mrWheel/DSMRloggerWS/mkdocs/docs/hardware_V4_Programmer.md

## Programmer voor de DSMR-logger V4

Er zijn verschillende manieren om de DSMR-logger van (nieuwe) firmware
te voorzien. Dit gaat het eenvoudigst *Over The Air* (OTA) maar de
eerste keer zal dit altijd bedraad moeten.

* [FTDI-adapter](#ftdi-adapter)
* [USB to Serial adaptor bordje](#usb-to-serial-adaptor-bordje)
* [USB to TTL adaptor kabel](#usb-to-ttl-serial-adaptor-kabel)
* [Flashen (programmeren)](#flashen-programmeren)

<hr>
### FTDI-adapter
Verreweg de betrouwbaarste oplossing is om gebruik te maken van een FTDI adaptor
zoals de 
<a href="https://opencircuit.nl/Product/15140/SparkFun-FTDI-Basic-Breakout-5V" target="_blank">
FTDI-basic</a>
van Adafruit.   
Hou er rekening mee dat de USB-connector op de FTDI-basic geen *micro*-USB is maar
de iets grotere *mini*-USB variant!

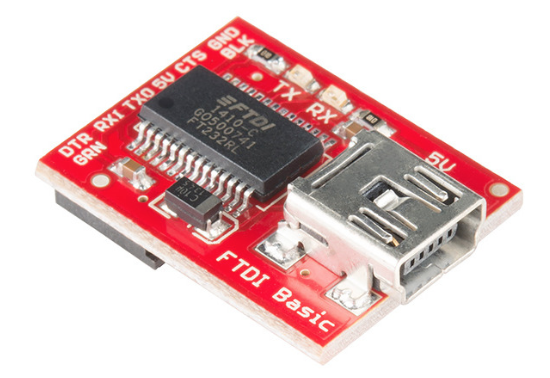
[picture p9: mkdocs/docs/img/Sparkfun_FTDI-basic_5v.png]


Standaard wordt deze als 5Volt adaptor geleverd, maar aan de achterkant kun je,
door het spoor tussen de middelste pad en de 5V pad te onderbreken en een soldeer 
brug aan te brengen tussen de middelste pad en de 3.3V pad, de adaptor
geschikt maken voor 3v3.

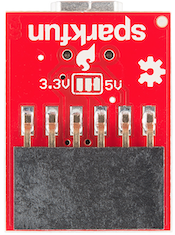
[picture p10: mkdocs/docs/img/Sparkfun_FTDI_Back.png]


Je moet de volgende verbindingen maken:

| FTDI-basic | DSMR-logger | Opmerking |
|:---:|:---:|:---|
| 5V  | 3v3 | LET OP! **3v3** |
| GND | GND ||
| TXO | RxD ||
| RXI | TxD ||

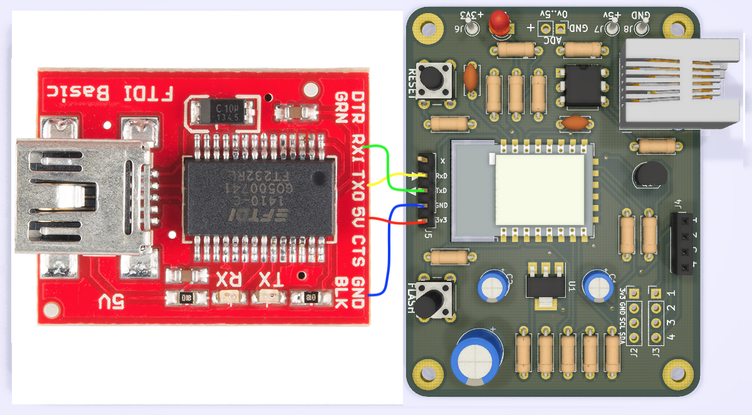
[picture p11: mkdocs/docs/img/DSMR-logger_V4-FTDI.png]


<hr>
### USB to Serial adaptor bordje
Ook een 
<a href="https://opencircuit.nl/Product/11544/ESP-01-USB-Adapter" target="_blank">
USB-to-Serial adapter</a>
is eenvoudig als programmer te gebruiken
door met vier draadjes verbinding tussen de USB-to-Serial Adapter en 
de *DSMR-logger v4* te maken volgens onderstaand schema:

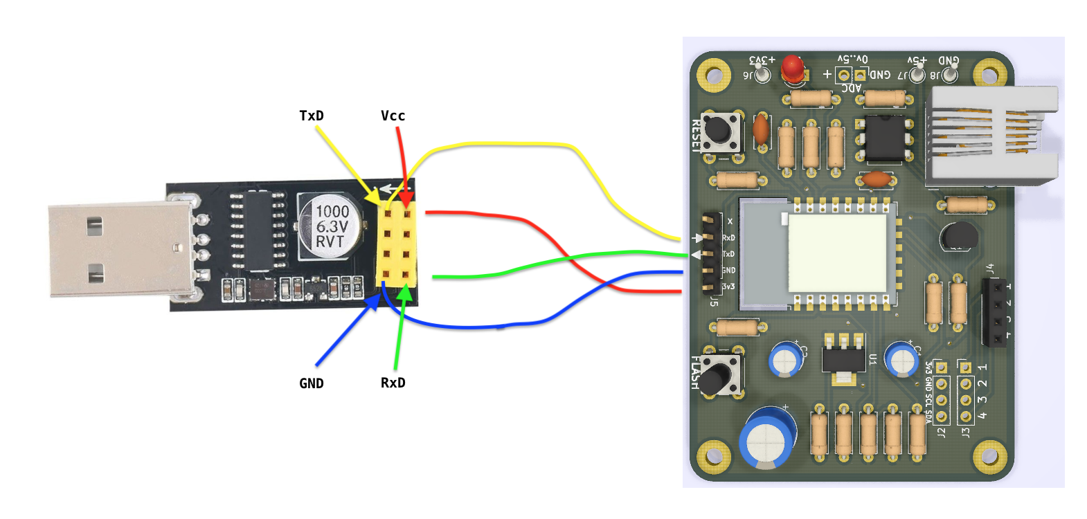
[picture p12: mkdocs/docs/img/USB2Serial_DSMRlogger_v4.png]


<del>Let op! Het heeft er alle schijn van dat dit bordje niet meer '*gezien*' wordt
onder **MacOS 10.14**!</del>

<hr>
### USB to TTL Serial adaptor kabel
Ook 
<a href="https://opencircuit.nl/Product/12809/USB-to-TTL-Serial-Cable-Debug-Console-Cable-for-Raspberry-Pi" target="_blank">
deze</a>
USB-to-Serial kabel is eenvoudig als programmer te gebruiken alleen moet je er 
rekening mee houden dat de geleverde spanning <b>5 volt</b> is en je deze dus
niet op de programming poort van de DSMR-logger V4 mag aansluiten.   
Sluit de USB-to-Serial kabel op deze manier aan om zonder problemen de
DSMR-logger V4 te kunnen programmeren.

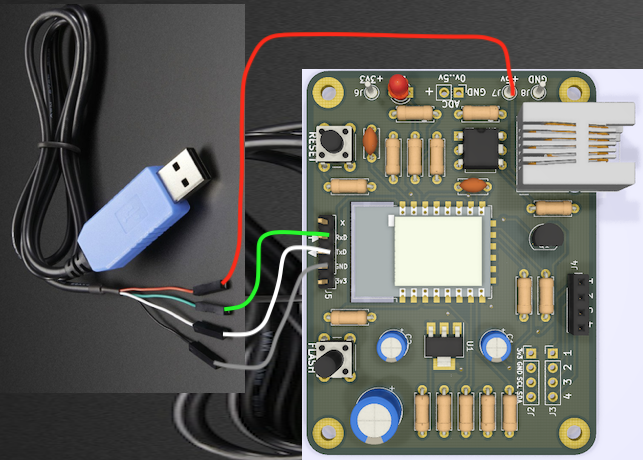
[picture p13: mkdocs/docs/img/USB2TTL_5Volt_DSMR-logger.png]


<hr>
### Flashen (programmeren)
Omdat de DSMR-logger V4 geen aansluitingen voor specifieke controle signalen heeft
moet je in de ArduinoIDE aangeven dat je bij het uploaden
van firmware of de `data`-map geen speciaal protocol gebruikt.
In het `Tools`-menu geef je bij `Reset Method` ***None*** op.

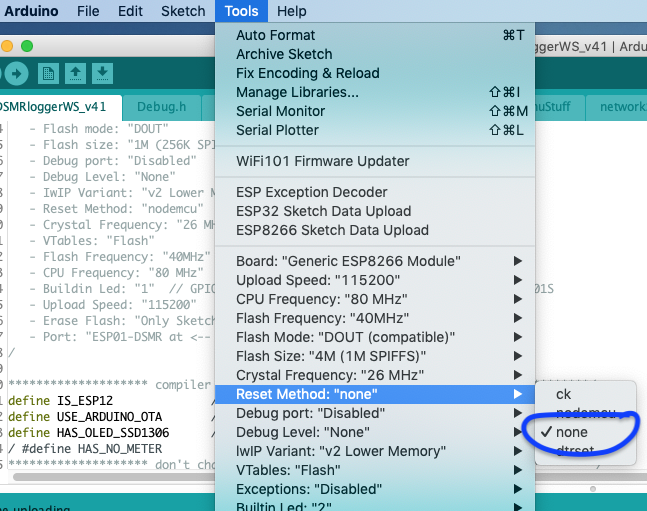
[picture p14: mkdocs/docs/img/ToolsResetMode.png]


Om nu de firmware of de `data`-map naar de *DSMR-logger v4* te flashen
moet je de *DSMR-logger v4* ***eerst*** in `Flash-mode` zetten.

<div class="admonition note">
<p class="admonition-title">Let op!</p>
Koppel, vóórdat je de programmer op de <i>DSMR-logger v4</i> aansluit, éérst
de <i>Slimme Meter</i> los!
</div>

Dit doe je door achtereenvolgens deze handelingen uit te voeren:

1. Druk op de `FLASH` knop en houdt deze ingedrukt
2. Druk vervolgens op de `RESET` knop
3. Laat de `RESET` knop los
4. Laat als laatste de `FLASH` knop los

De DSMR-logger staat nu in `Flash-mode`  en blijft in die mode tot er firmware
of de inhoud van de `data`-map wordt ge-upload (of tot je nog een keer op de
`RESET` knop drukt).

Hierna hoort de DSMR-logger normaal op te starten. Mocht dit niet het geval zijn
druk dan 1x op de `RESET` knop..

Zie ook [`Vraag en Antwoord`](QenA.md#5-volt-programmer)

<br>

---
<center style="font-size: 70%;">[ChartActueel]</center>
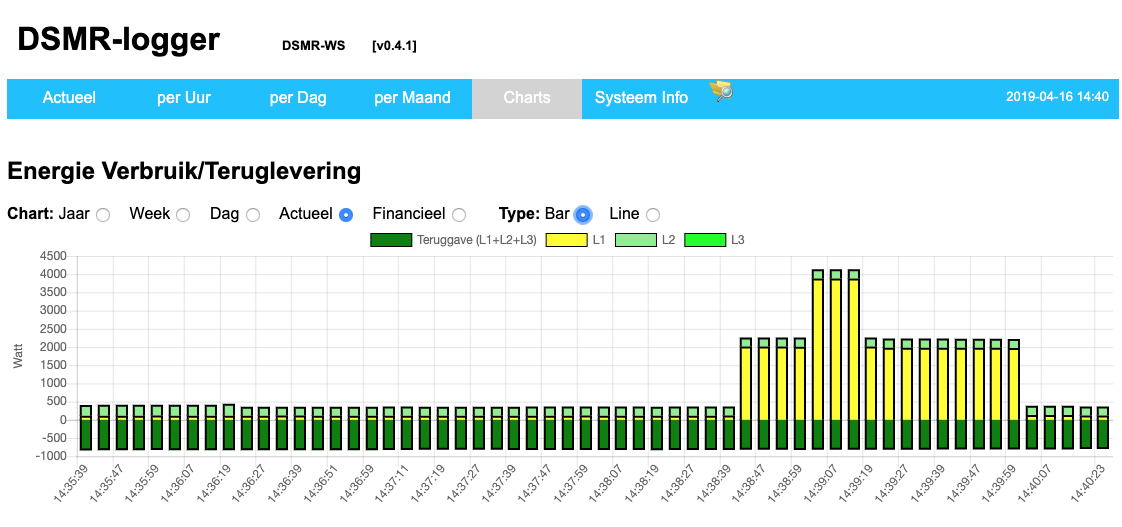
[picture p15: mkdocs/docs/img/ChartActueel.png]
