mrWheel/DSMRloggerWS/mkdocs/docs/benodigdeBibliotheken.md

## Benodigde Bibliotheken

Voor de **DSMRloggerWS** firmware zijn de volgende bibliotheken nodig:

<hr>
### dsmr
Deze library is ontwikkeld door *Matthijs Kooijman* en vormt het hart van de
DSMR-logger. Je kunt de bibliotheek hier
<a href="https://github.com/matthijskooijman/arduino-dsmr" target="_blank">
https://github.com/matthijskooijman/arduino-dsmr</a>
downloaden.   
De firmware is getest met `Version 0.1 - Commit f79c906 on 18 Sep 2018`
maar nieuwere versies zullen waarschijnlijk ook werken.

<hr>
### TimeLib
Deze is door *Paul Stoffregen* ontwikkeld. Je kunt hem hier
<a href="https://github.com/PaulStoffregen/Time" target="_blank">
https://github.com/PaulStoffregen/Time</a>
downloaden.

<hr>
### WiFiManager
Je kunt de, door *Tzapu* ontwikkelde, bibliotheek hier
<a href="https://github.com/tzapu/WiFiManager" target="_blank">
https://github.com/tzapu/WiFiManager</a>
downloaden.   
De DSMR-logger firmware is getest met `version 0.14.0` van deze bibliotheek
maar nieuwere versies zullen waarschijnlijk ook werken.

<hr>
### TelnetStream
Deze bibliotheek is door *Juraj Andrassy* ontwikkeld.
Je kunt deze bibliotheek hier
<a href="https://github.com/jandrassy/TelnetStream" target="_blank">
https://github.com/jandrassy/TelnetStream</a>
downloaden.   
De firmware is getest met `version 0.0.1` maar nieuwere versies zullen waarschijnlijk
ook werken.

**Let op:** De installatie van deze bibliotheek gaat net als de andere bibliotheken. Een update 
kan echter pas geïnstalleerd worden als éérst de map `TelnetStream-master` uit de
map `Libraries` wordt verwijderd! 

<hr>
### WebSocketsServer
Deze bibliotheek is ontwikkeld door *Markus Sattler* en je kunt hem hier
<a href="https://github.com/Links2004/arduinoWebSockets/" target="_blank">
https://github.com/Links2004/arduinoWebSockets</a>
downloaden.   
De DSMR-logger firmware is getest met <b><i>Version 20.05.2015 - 
<a href="https://github.com/Links2004/arduinoWebSockets/tree/72731beb10c18c6247c6b511f2f46a452ef293c3" target="_blank">commit 72731be</a>
on 16 Jan 2019</i></b> maar nieuwere versies zullen waarschijnlijk ook werken.

<hr>
### SSD1306Ascii
*William Greiman* heeft deze bibliotheek ontwikkeld met in het achterhoofd minimaal 
gebruik van resources (dus: een bibliotheek die weinig geheugen gebruikt).
Je kunt de bibliotheek hier
<a href="https://github.com/greiman/SSD1306Ascii" target="_blank">
https://github.com/greiman/SSD1306Ascii</a>
downloaden.     
De DSMR-logger Firmware is getest met `Version 1.2.x - Commit 97a05cd on 24 Mar 2019`
maar nieuwere versies zullen waarcshijnlijk ook werken.

<hr>
### PubSubClient
*Nick O'Leary (knolleary)* heeft deze bibliotheek ontwikkeld.
Je kunt de bibliotheek hier
<a href="https://github.com/knolleary/pubsubclient" target="_blank">
https://github.com/knolleary/pubsubclient</a>
downloaden.     

<hr>
### ArduinoJson
Copyright *Benoit Blanchon* 2014-2019
<br>De DSMR-logger Firmware is getest met `Version 6.13.0` van ArduinoJson.
<br>Je kunt de bibliotheek hier
<a href="https://github.com/bblanchon/ArduinoJson/releases" target="_blank">
https://github.com/bblanchon/ArduinoJson.git</a>
downloaden.     

<hr>
### ModUpdateServer
Deze bibliotheek maakt het mogelijk om firmware en SPIFFS Over The Air
te flashen naar de DSMR-logger.
<br>Deze bibliotheek is nodig vanaf versie 2.6.3 van de Arduino/ESP8266 core.
Je kunt de bibliotheek hier
<a href="https://github.com/mrWheel/ModUpdateServer" target="_blank">
https://github.com/mrWheel/ModUpdateServer</a> downloaden.

<hr>
### dsmr30
<div class="admonition note">
<p class="admonition-title">Let op!  Deze functionaliteit is slechts beperkt getest!</p>
</div>
Heb je een pré DSMR 4.0 Slimme Meter dan kun je deze toch aansluiten op de DSMR-logger
maar moet je een aantal `define`'s in het eerste tab-blad aanpassen én je moet
<a href="https://github.com/mrWheel/arduino-dsmr30" target="_blank">
deze</a> library installeren.
Kijk ook [hier](Use_Pre40_Protocol.md).

<hr>
### Overige libraries
Onderstaande libraries zijn onderdeel van de `ESP8266 Core` **en moeten dus niet handmatig
geïnstalleerd worden**!

	* ESP8266WiFi    
	* ESP8266WebServer
	* WiFiUdp        
	* ESP8266mDNS   
	* FS           
	* ArduinoOTA  

<br>

---
<center style="font-size: 70%">[DSMR-Chart Dag]</center><br>
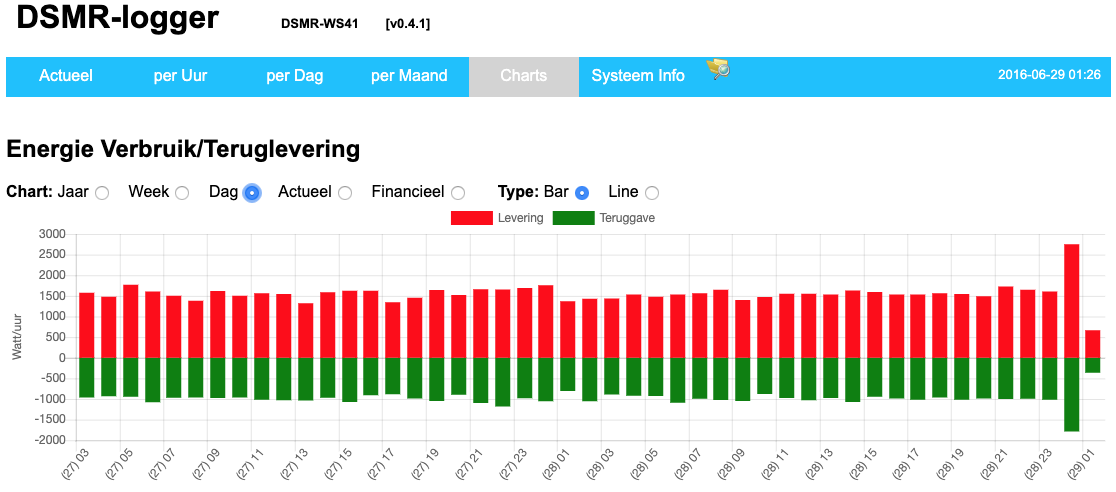
[picture p20: mkdocs/docs/img/ChartDag.png]
