mrWheel/DSMRloggerWS/DSMR3Dbox/README.md

### DSMR3Dbox

Deze DSMR3Dbox voor de DSMR-logger V4 is ontworpen door <b><i>Gerard</b></i>.

Het model is nog niet geprint dus mogelijkerwijs moet er hier en daar
nog wat aan geschaafd worden!

<hr>

<b><i>Allart van den Berg</i></b> heeft ook een mooi kastje ontworpen voor een 
DSMR-logger V4 
<a href="https://www.thingiverse.com/thing:3784503" target="_blank" rel="noopener noreferrer nofollow">
zonder Oled scherm</a> ...

... en één voor een DSMR-logger V4 
<a href="https://www.thingiverse.com/thing:3792538" target="_blank" rel="noopener noreferrer nofollow">
mét OLED scherm</a>!
