mrWheel/DSMRloggerWS/mkdocs/docs/index.md

# Documentatie DSMRloggerWS 

Voor de project beschrijving ga naar 
<a href="https://willem.aandewiel.nl/index.php/2019/04/09/dsmr-logger-v4-slimme-meter-uitlezer/" target = "_blank">www.aandewiel.nl</a>

## Inhoudsopgave

* [Introductie](introductie.md)
* Voorbereiding
    *  [ArduinoIDE](installatieArduinoIDE.md)
    *  [ESP8266 core](installatieESP8266core.md)
    *  [Data Upload Tool](installatieDataUploadTool.md)
    *  [Installeren Bibliotheken](installatieBibliotheken.md)
* Firmware
    *  [Benodigd Bibliotheken](benodigdeBibliotheken.md)
    *  [DSMR Firmware van Github](clonenFirmware.md)
    *  [Firmware Flashen DSMR-logger V4 board](uploadFirmware_V4.md)
    *  [Data Flashen naar DSMR-logger V4 board](uploadDataMap_V4.md)
    *  [Firmware Flashen DSMR-logger V3 board](uploadFirmware_V3.md)
    *  [Data Flashen naar DSMR-logger V3 board](uploadDataMap_V3.md)
    *  [Pré DSMR 4.0 Slimme Meters](Use_Pre40_Protocol.md)
* Selectie Functies
     * [DSMR-logger V4 met ESP-12](Is_ESP12.md)
     * [Over The Air update](Use_Update_Server.md)
     * [0.96" OLED display](Has_OLED_SSD1306.md)
     * [1.3" OLED display](Has_OLED_SH1106.md)
     * [Gebruik MQTT](Use_MQTT.md)
     * [Gebruik Mindergas.nl](Use_Mindergas.md) 
     * [Pré DSMR 4.0 Slimme Meters](Use_Pre40_Protocol.md)
     * [Network Time](Use_NTP_Time.md)
     * [SM geeft geen info per Fase](SM_Has_No_Fase_Info.md)
     * [Toon wachtwoorden](Show_Passwrds.md)
     * [Test mode](Has_No_Meter.md)
* Hardware
    *  [DSMR-logger Versie 4](hardware_V4.md)
    *  [DSMR-logger Versie 4.5](hardware_V4.5.md)
    *  [Programmer voor de DSMR-logger V4](hardware_V4_Programmer.md)
    *  [DSMR-logger Versie 3](hardware_V3.md)
    *  [Programmer voor de ESP-01](hardware_V3_Programmer.md)
* Overigen
    *  [(Eerste keer) Opstarten](Opstarten.md)
    *  [gebruik restAPI](restAPI.md)
    *  [Verschillen ESP8266 modules](verschillenESP8266.md)
    *  [Over The Air (bug?)](uploadOTA-bug.md)
    *  [PUYA flash chip](PUYA_patch.md)
    *  [Vragen en Antwoorden](QenA.md)
* Integratie met andere systemen
    *  [Integratie met Domoticz](integratieDomoticz.md)
    *  [Integratie met Homey](integratieHomey.md)
    *  [Integratie met Home Assistant](integratieHassio.md)
    *  [Integratie met Mindergas](integratieMindergas.md)
* Telnet
    *  [telnet logging](telnet.md)

<br>

---
<center  style="font-size: 70%">[ScreenShot DSMR-Actueel]</center><br>
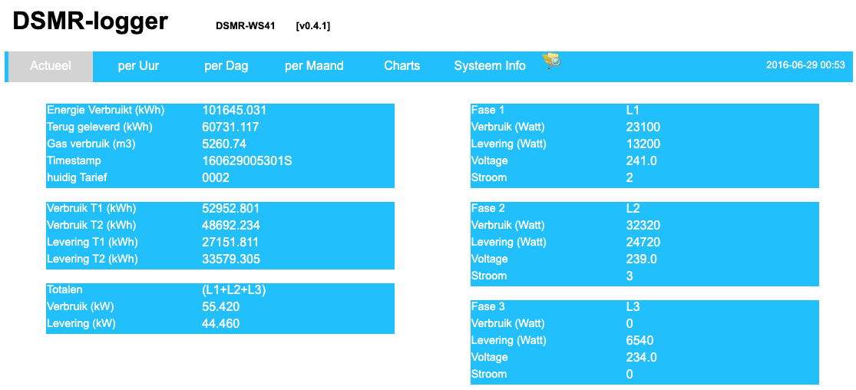
[picture p37: mkdocs/docs/img/TabelActueel.png]
