mrWheel/DSMRloggerWS/mkdocs/docs/Has_OLED_SSD1306.md

## #define HAS_OLED_SSD1306

Als je een OLED schermpje op <b>J4</b> van de DSMR-logger V4 hebt aangesloten
dan zorgt deze optie ervoor dat het OLED schermpje ook gebruikt wordt door de Firmware.

<div class="admonition note">
<p class="admonition-title">Let op!  Alleen voor DSMR-logger V4</p>
</div>

<table>
<tr>
<th align="left">#define</th><th align="left">Functie</th>
</tr><tr>
<td style="vertical-align:top">USE_OLED_SSD1306</td><td>Deze define zorgt ervoor dat
het 0.96" OLED schermpje gebruikt wordt om meldingen op te presenteren.
<br>Deze define kan niet in combinatie met <b>HAS_OLED_SH1106</b>!
</td>
</tr>
</table>

---
<center  style="font-size: 70%">[DSMRlogger AP Mode]</center><br>
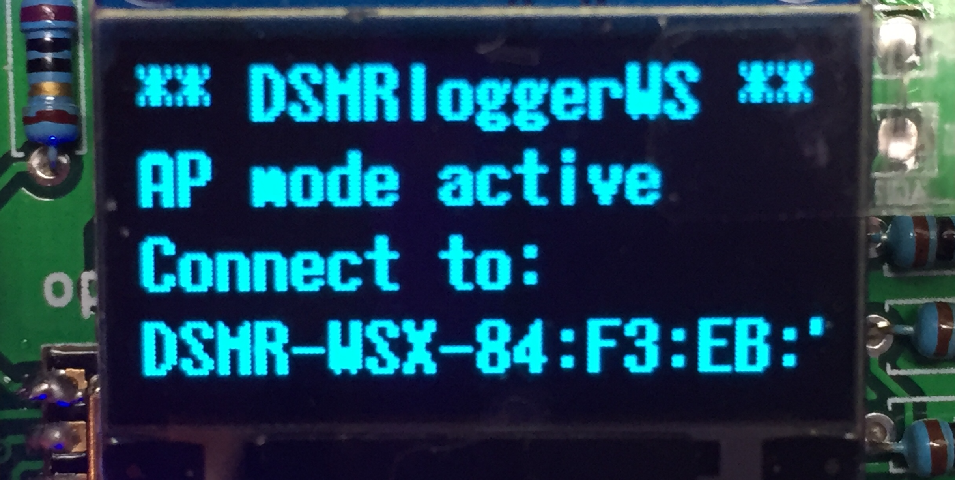
[picture p47: mkdocs/docs/img/DSMR_AP_Mode.png]
