mrWheel/DSMRloggerWS/mkdocs/docs/integratieDomoticz.md

## Integratie DSMR-logger met Domoticz
`Michel Groen` heeft een script voor 
<a href="http://www.domoticz.com/" target="_blank">Domoticz</a>
geschreven waarmee data uit de DSMR-logger in Domoticz kan worden weergegeven.

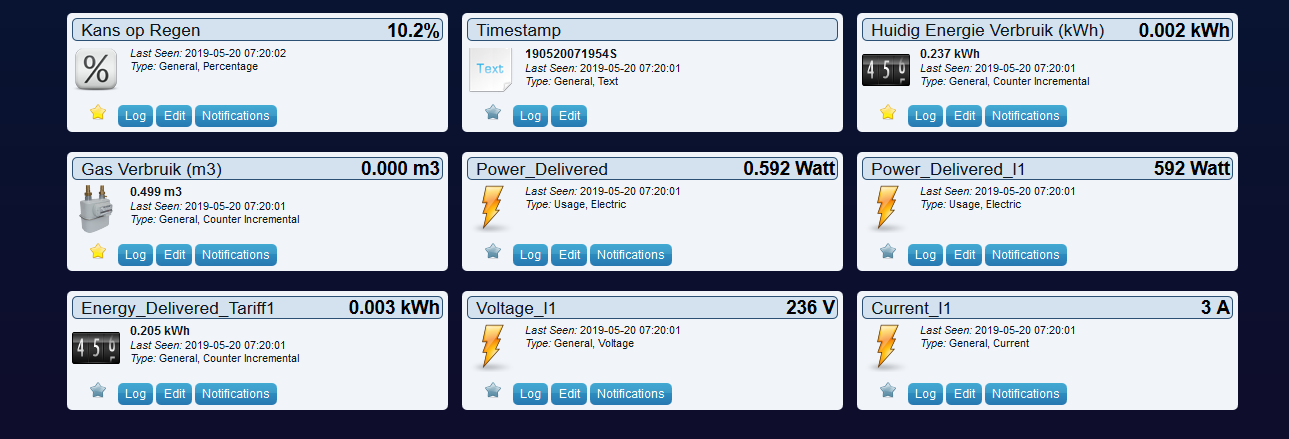
[picture p48: mkdocs/docs/img/Logger-Domoticz1.png]


Je kunt het script vinden in de `DSMRloggerWS` repository op github, in de
sub-map <a href="https://github.com/mrWheel/DSMRloggerWS/tree/master/Koppelingen/Domoticz" target="_blank">
`Domoticz`
</a>.

<br>
---
<center style="font-size: 70%;">[Domoticz]</center><br>

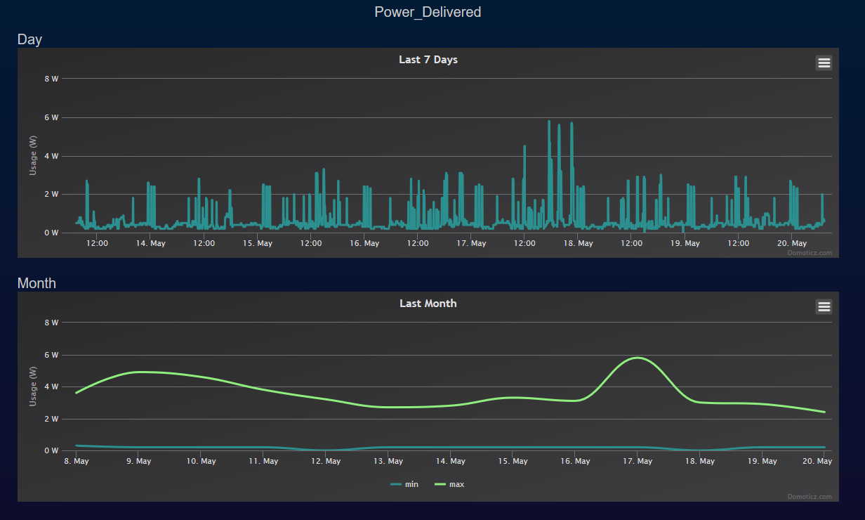
[picture p49: mkdocs/docs/img/Logger-Domoticz2.png]
