mrWheel/DSMRloggerWS/mkdocs/docs/integratieHomey.md

## Integratie DSMR-logger met Homey
`Tycho Schenkeveld` heeft een interface tussen
de DSMR-logger en Homey gemaakt en deze op 
<a href="https://github.com/TychoSchenkeveld/com.p1.dsmr" target="_blank">
github</a> geplaatst!

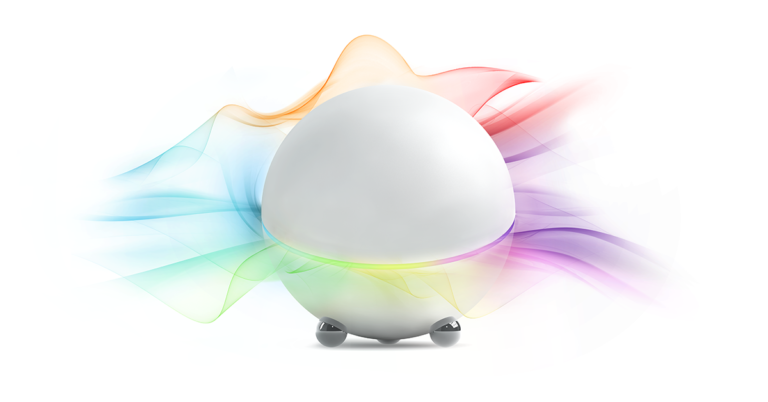
[picture p52: mkdocs/docs/img/Homey-Ring.png]


<hr>
