mrWheel/DSMRloggerWS/mkdocs/docs/clonenFirmware.md

## Clonen Firmware
De **DSMRloggerWS** firmware staat hier
<a href="https://github.com/mrWheel/DSMRloggerWS" target="_blank">
https://github.com/mrWheel/DSMRloggerWS</a>.

Er zijn twee manieren om de firmware te clonen.

1. download de repository als een `.zip` file
2. gebruik `git`

Als je niet handig bent met `git` raad ik je aan de repository als een `.zip` file te downloaden.

<hr>
### Download .zip file

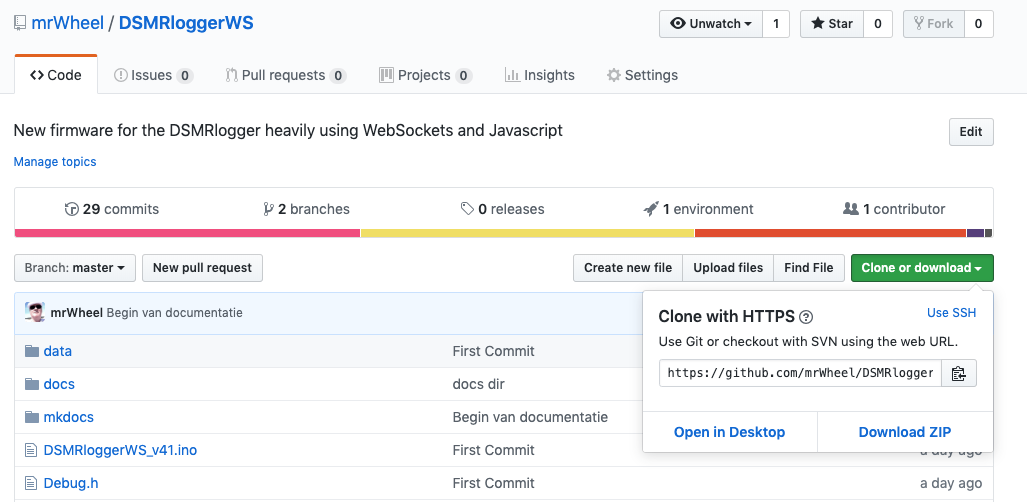
[picture p53: mkdocs/docs/img/GIT_Clone1.png]


Klik op de groene knop
<span style="background: green; color: white;">[Clone or Download]</span> ..

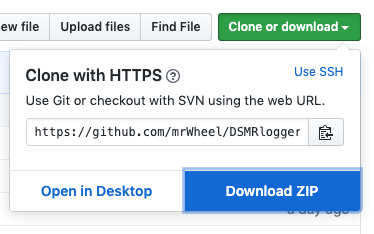
[picture p54: mkdocs/docs/img/GIT_Clone2.png]


.. en selecteer
<span style="background: blue; color: white;">[Download ZIP]</span>

Er volgt een scherm als dit:

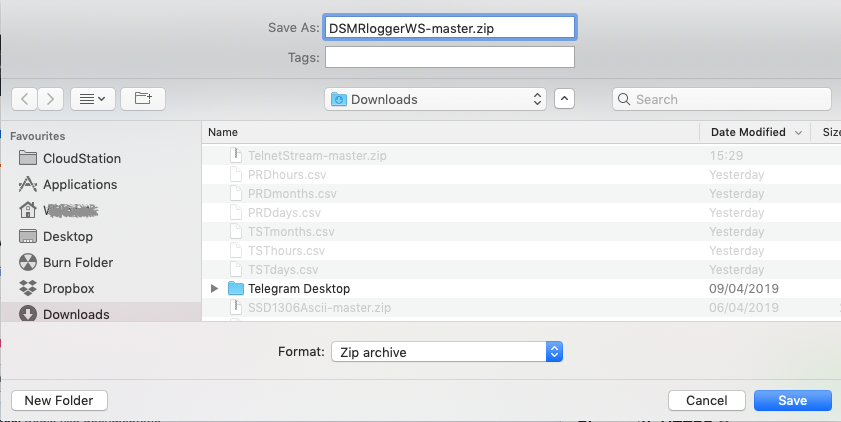
[picture p55: mkdocs/docs/img/GIT_SaveZIP.png]


1. Bewaar het `.zip` bestand op een plek op je computer waar je hem terug kunt vinden.
2. Unzip het `DSMRloggerWS-master.zip` bestand in de ArduinoIDE `Sketchbook Location`.
3. Rename de map `DSMRloggerWS-master` naar `DSMRloggerWS` (dus zonder `-master`)

Ga verder naar [DSMRloggerWS Sketch openen](#dsmrloggerws-sketch-openen)

<hr>
### git clone
Om de repository met `git` te kunnen clonen moet je er éérst voor zorgen dat je `git` 
op je systeem hebt staan. Hoe je dat moet doen valt buiten de scope van deze documentatie
maar
<a href="https://git-scm.com/book/nl/v1/Aan-de-slag-Git-installeren" target="_blank">
hier</a>
kun je alles vinden over hoe je dit, voor jouw systeem, moet doen.

Voor nu ga ik ervan uit dat je `git` op je systeem hebt staan en dat je weet hoe je
ermee moet werken.

Ga naar de Arduino `Sketchbook location` (de map waar al je Sketches in staan, 
[kijk hier](installatieESP8266core.md))
en toets het volgende commando in:
```
git clone https://github.com/mrWheel/DSMRloggerWS.git
```
That's it!

In `Sketchbook location` staat hierna een nieuwe map met de naam `DSMRloggerWS`. 

<hr>
### DSMRloggerWS Sketch openen
Start de ArduinoIDE ***opnieuw*** op en klik op het `open` icoon 
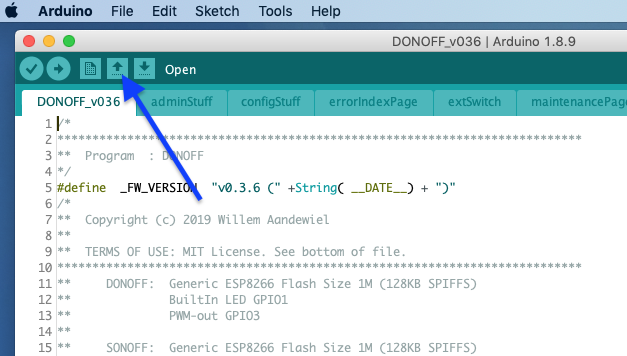
[picture p56: mkdocs/site/img/IDE_Load-a.png]
.

Selecteer in het `drop-down` menu ..

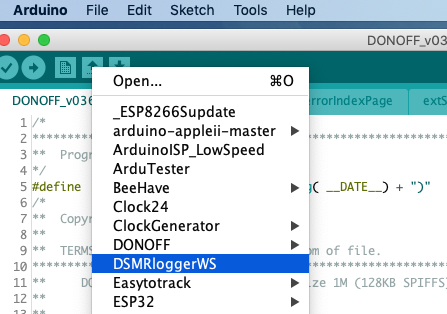
[picture p57: mkdocs/docs/img/IDE_Load-b.png]


.. de sketch `DSMRloggerWS`<br>
Er verschijnt een nieuw editor window met de firmware van de DSMRlogger!

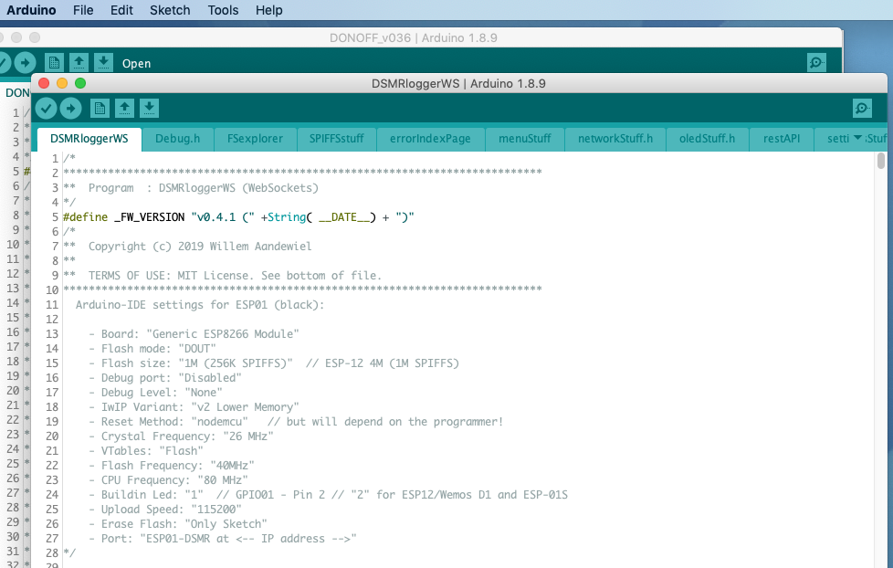
[picture p58: mkdocs/docs/img/IDE_Load-c.png]


<br>

----
<center style="font-size: 70%">[DSMR-Settings]</center><br>
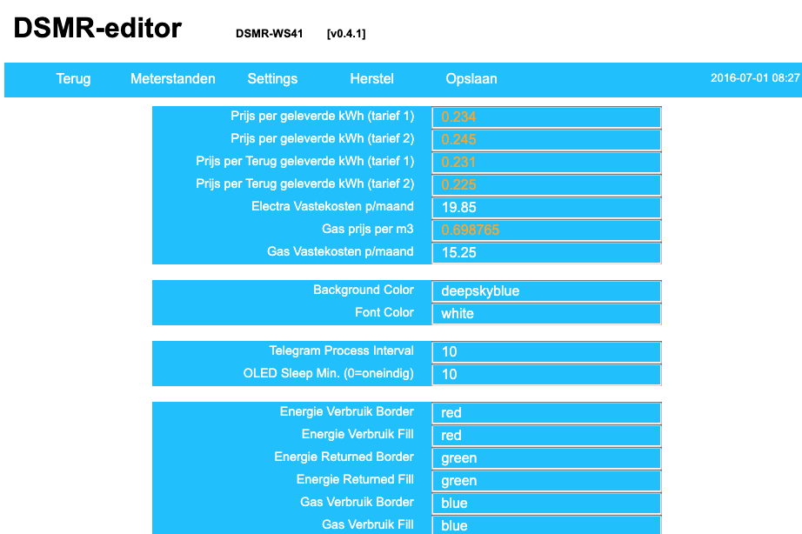
[picture p59: mkdocs/docs/img/DSMRsettings.png]
