mrWheel/DSMRloggerWS/mkdocs/docs/hardware_V3.md

## DSMR-logger Versie 3

Hoe je een DSMRlogger Versie 2 kunt bouwen staat 
<a href="https://github.com/mrWheel/DSMRlogger2HTTP/blob/master/Bouwbeschrijving.pdf" target="_blank">
hier</a>
uitvoerig beschreven.

Versie 3 is gelijk aan Versie 2 met dit verschil dat de transistor en voltage regulator
eenvoudiger zijn te solderen omdat de pad's verder uit elkaar staan.

Versie 3 heeft ook een RJ12 connector waardoor de draadbreuken die met Versie 2
nog wel eens voorkwamen verleden tijd zijn.

Een kitje voor Versie 3 kun je 
<a href="https://opencircuit.nl/Product/13859/Slimme-meter-uitlezer-V3-bouwpakket-met-ESP-01" target="_blank">
hier</a>
bestellen.

<br>
---
<center style="font-size: 70%;">[DSMRlogger Versie 3]</center><br>

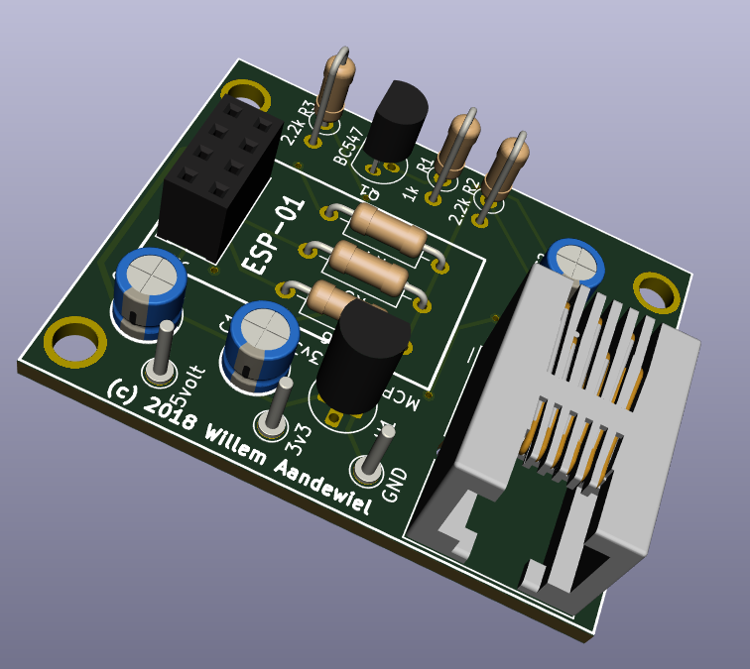
[picture p60: mkdocs/docs/img/DSMR_3D_v3.png]
