mrWheel/DSMRloggerWS/mkdocs/docs/hardware_V3_Programmer.md

## Programmer voor de ESP-01

Je kunt op
<a href="https://willem.aandewiel.nl/index.php/2018/08/27/eenvoudige-programmer-voor-de-esp-01-esp8266/" target="_blank">
www.aandewiel.nl</a>
een post vinden met instructies hoe je eenvoudige een programmer
voor de ESP-01 kunt maken.

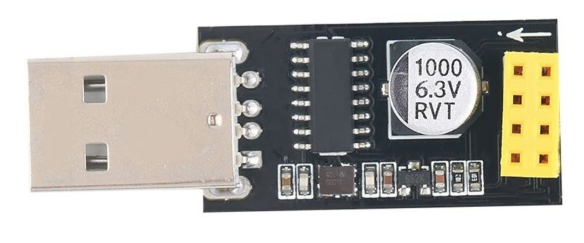
[picture p61: mkdocs/docs/img/USB2SerialAdapter.png]


<br>

---
<center style="font-size: 70%;">[TabelMaand]</center><br>

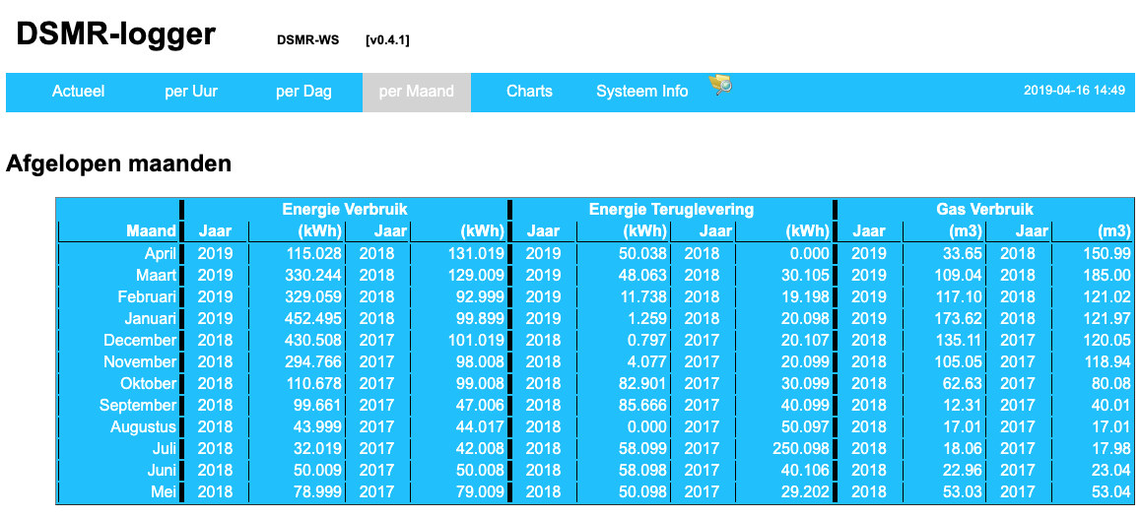
[picture p62: mkdocs/docs/img/TabelMaand.png]
