mrWheel/DSMRloggerWS/DSMR3Dbox/DSMR3Dbox.png

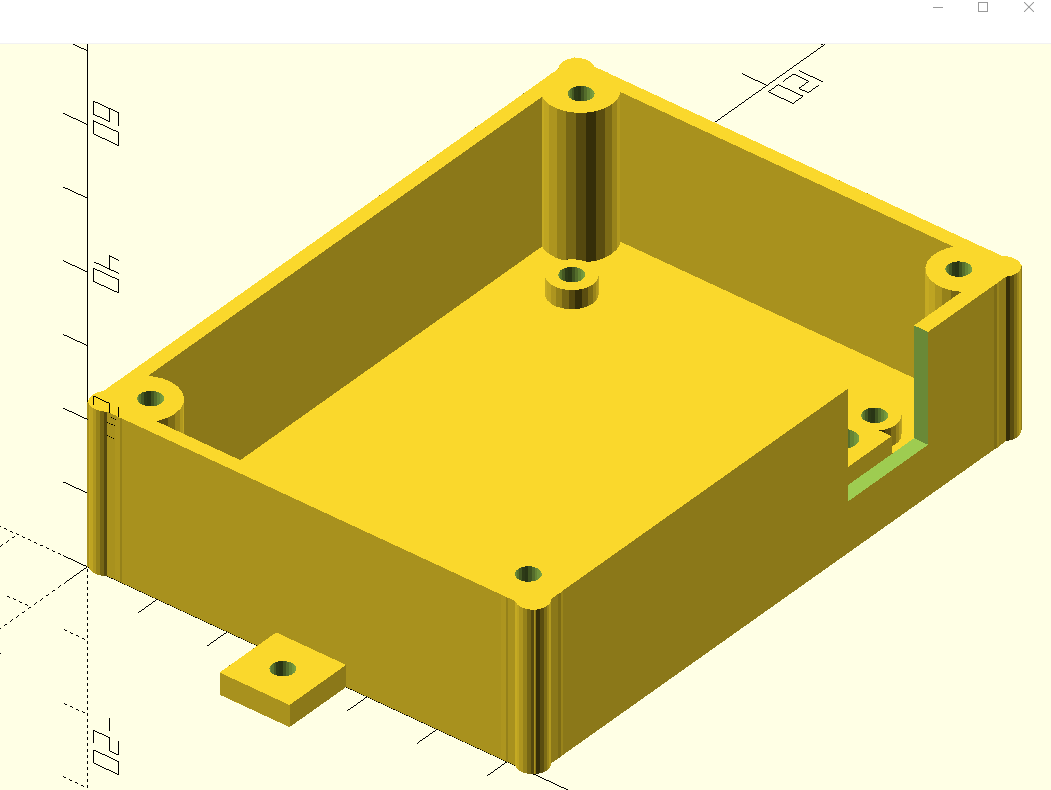
DSMR3Dbox/DSMR3Dbox.png
