mrWheel/DSMRloggerWS/mkdocs/docs/img/4N35-optocoupler-pinout.png

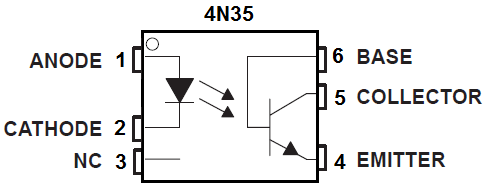
mkdocs/docs/img/4N35-optocoupler-pinout.png
