mrWheel/DSMRloggerWS/mkdocs/docs/img/4N35_dot.jpg

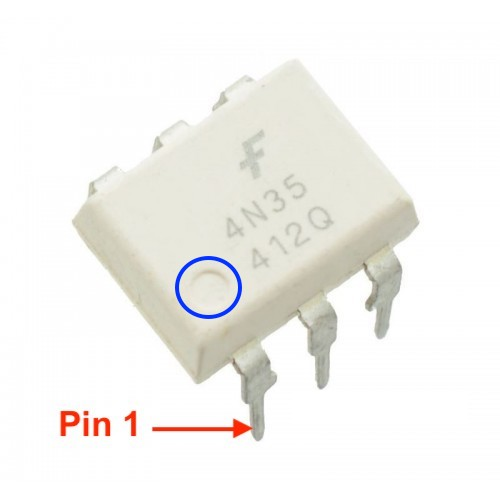
mkdocs/docs/img/4N35_dot.jpg
