mrWheel/DSMRloggerWS/mkdocs/docs/img/4N35_groove.jpg

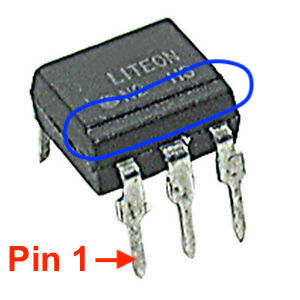
mkdocs/docs/img/4N35_groove.jpg
