mrWheel/DSMRloggerWS/mkdocs/docs/img/4N35_slot.jpg

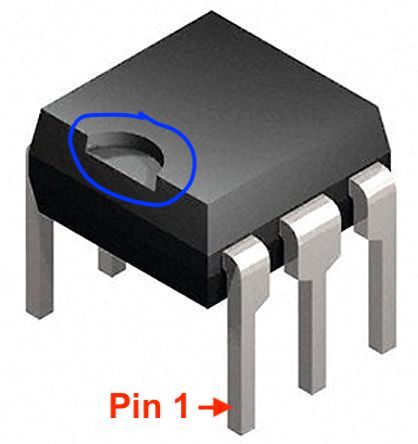
mkdocs/docs/img/4N35_slot.jpg
