mrWheel/DSMRloggerWS/mkdocs/docs/img/ChartWeekLine.png

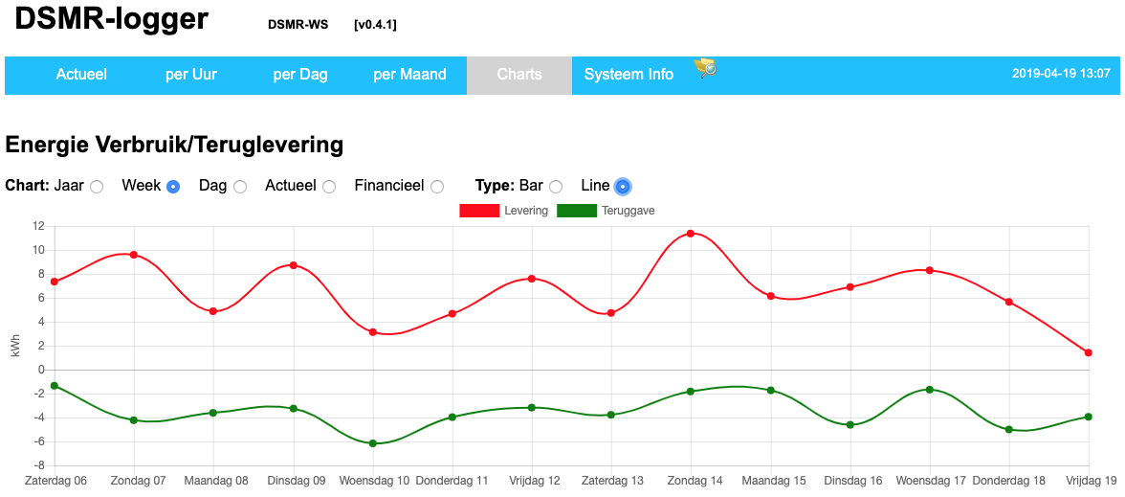
mkdocs/docs/img/ChartWeekLine.png
