mrWheel/DSMRloggerWS/mkdocs/docs/img/DSMR-logger_V4_Schema.png

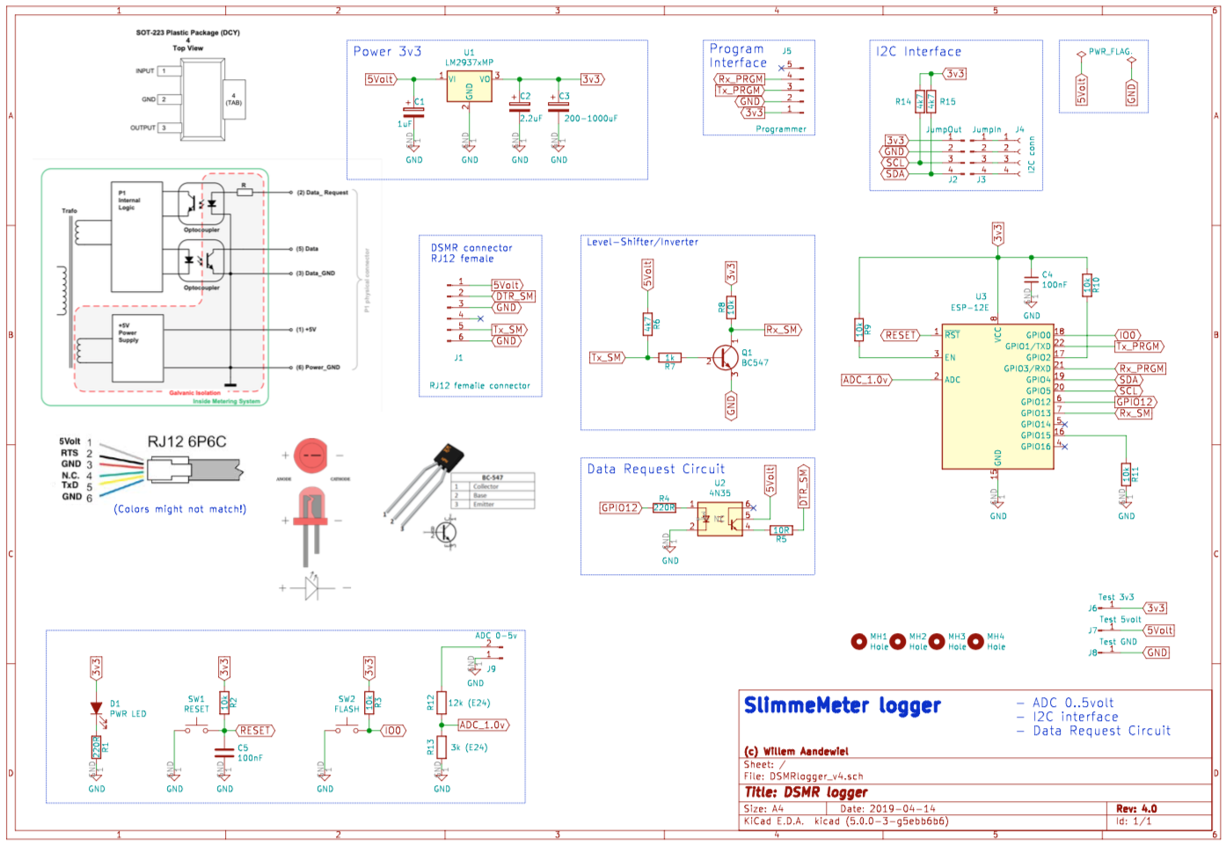
mkdocs/docs/img/DSMR-logger_V4_Schema.png
