mrWheel/DSMRloggerWS/mkdocs/docs/img/DSMR_FSexplorer.png

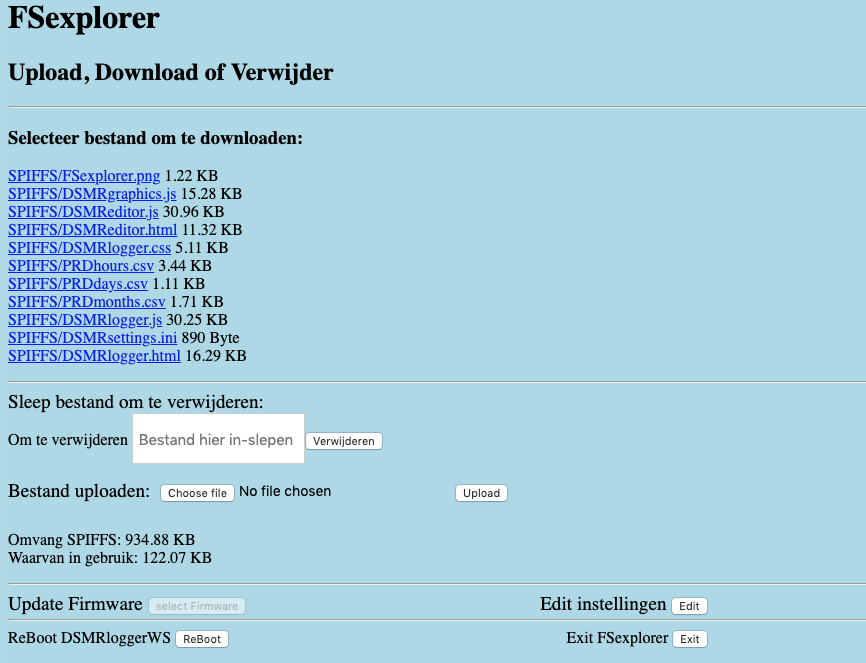
mkdocs/docs/img/DSMR_FSexplorer.png
