mrWheel/DSMRloggerWS/mkdocs/docs/img/DSMR_V4_Maten2.png

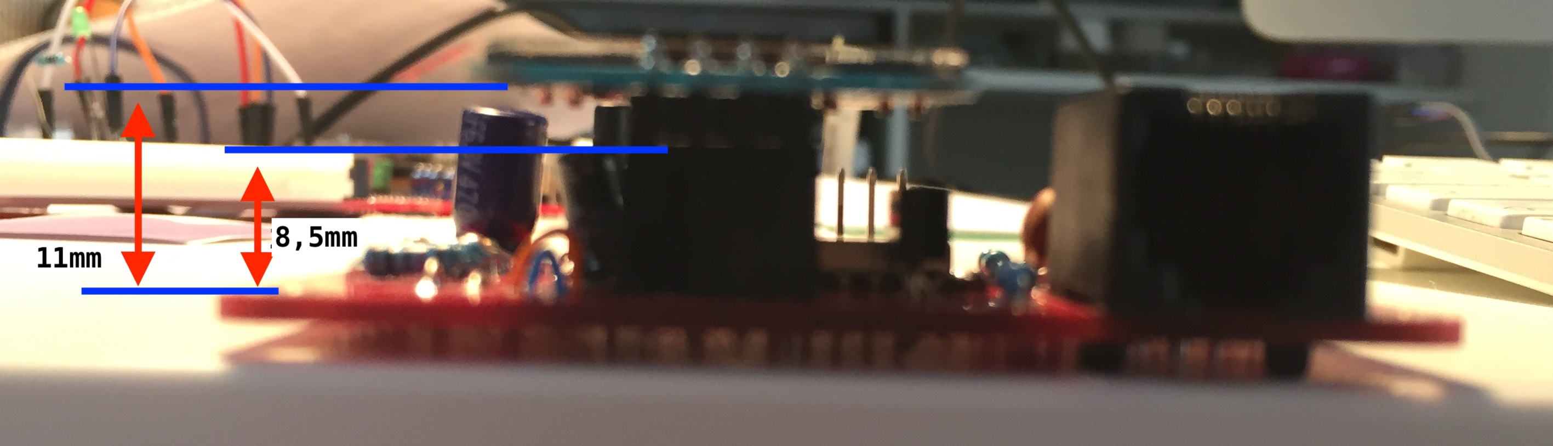
mkdocs/docs/img/DSMR_V4_Maten2.png
