mrWheel/DSMRloggerWS/mkdocs/docs/img/DSMR_V4_Maten.jpg

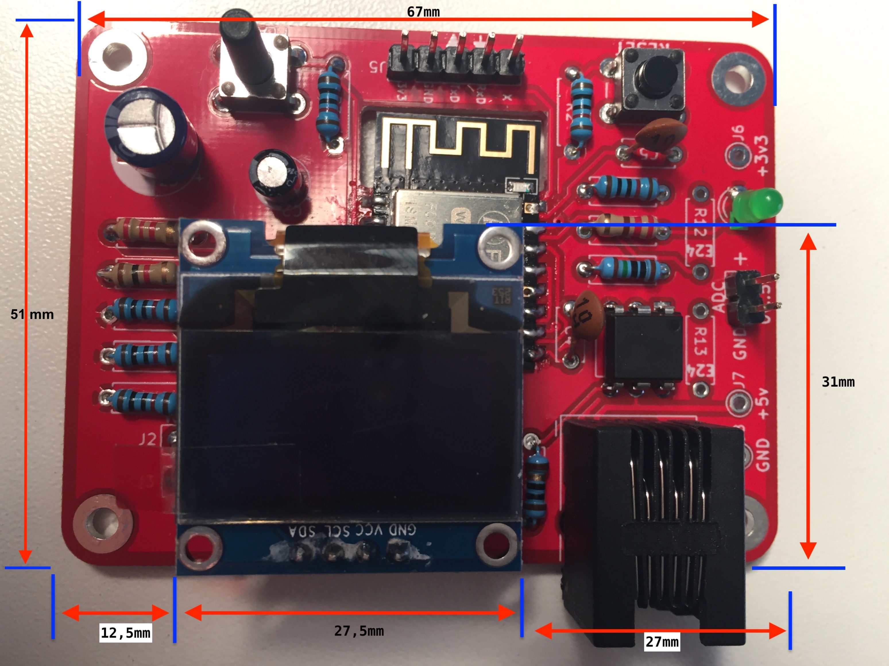
mkdocs/docs/img/DSMR_V4_Maten.jpg
