mrWheel/DSMRloggerWS/mkdocs/docs/img/DSMRlogger_v4_3D.png

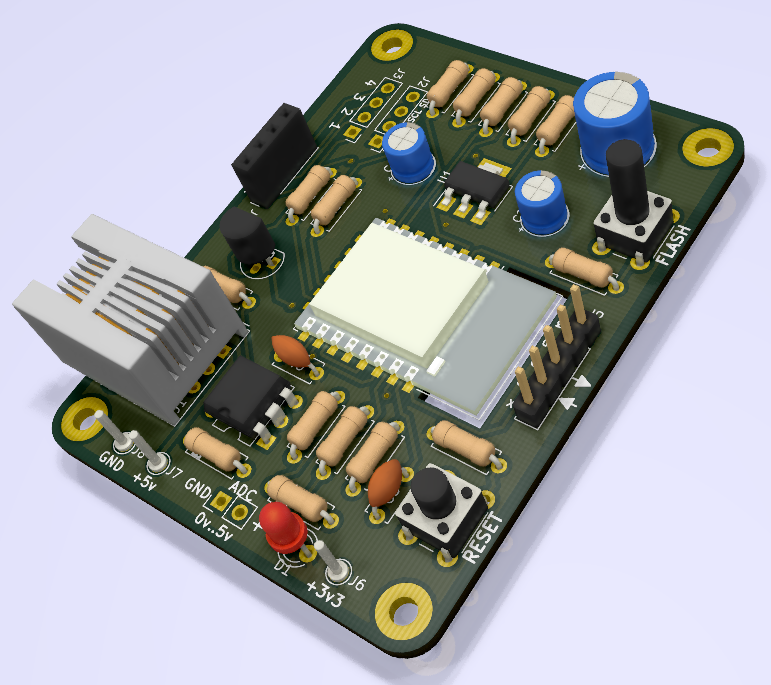
mkdocs/docs/img/DSMRlogger_v4_3D.png
