mrWheel/DSMRloggerWS/mkdocs/docs/img/DSMRlogger_v4_Top_3D.png

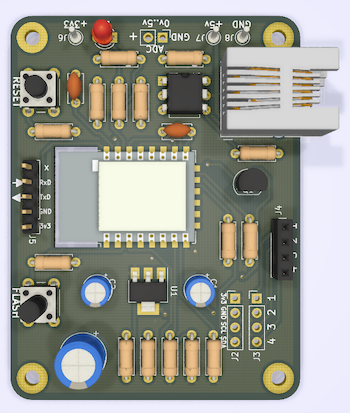
mkdocs/docs/img/DSMRlogger_v4_Top_3D.png
