mrWheel/DSMRloggerWS/mkdocs/docs/img/ESP01_BoardSettings.png

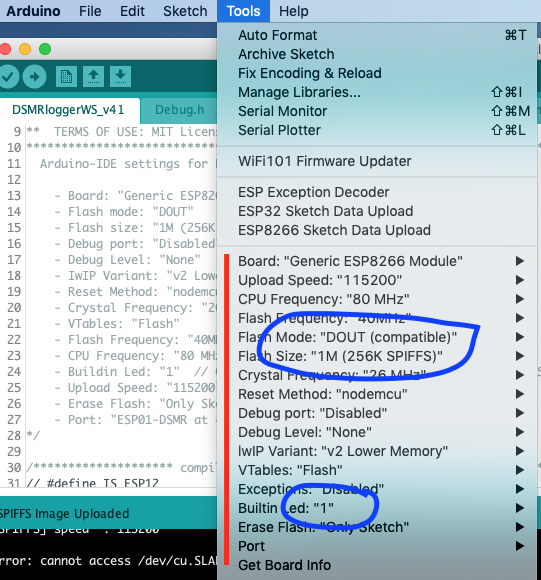
mkdocs/docs/img/ESP01_BoardSettings.png
