mrWheel/DSMRloggerWS/mkdocs/docs/img/ESP12_BoardSettings.png

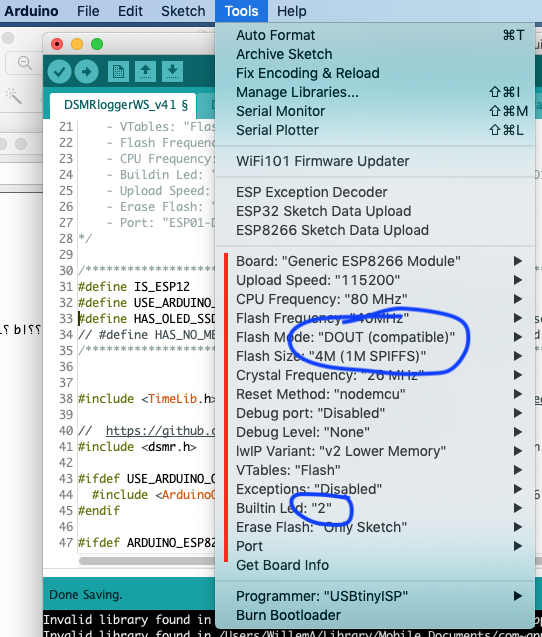
mkdocs/docs/img/ESP12_BoardSettings.png
