mrWheel/DSMRloggerWS/mkdocs/docs/img/FirstStartIDE.png

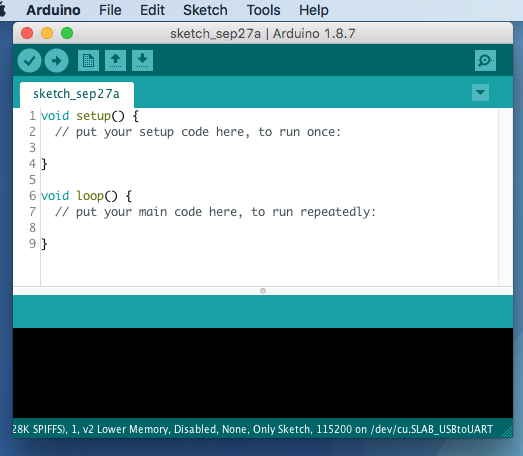
mkdocs/docs/img/FirstStartIDE.png
