mrWheel/DSMRloggerWS/mkdocs/docs/img/IDE_DSMRlogger.png

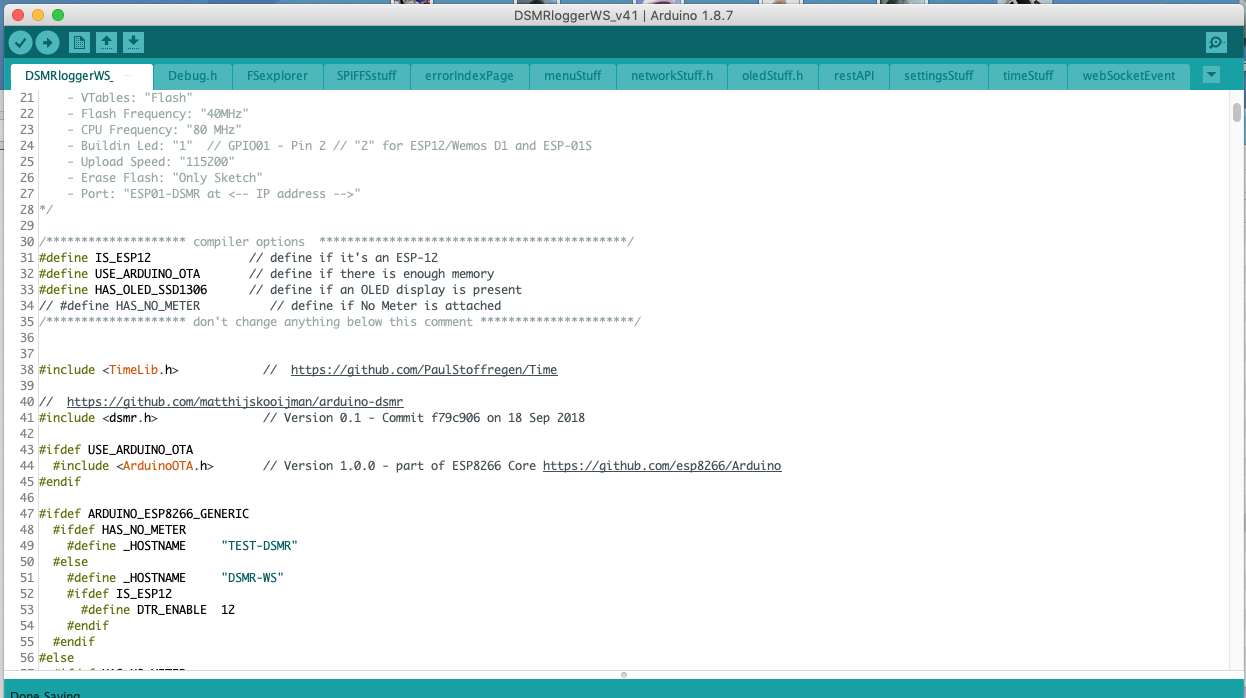
mkdocs/docs/img/IDE_DSMRlogger.png
