mrWheel/DSMRloggerWS/mkdocs/docs/img/IDE_Network_Port.png

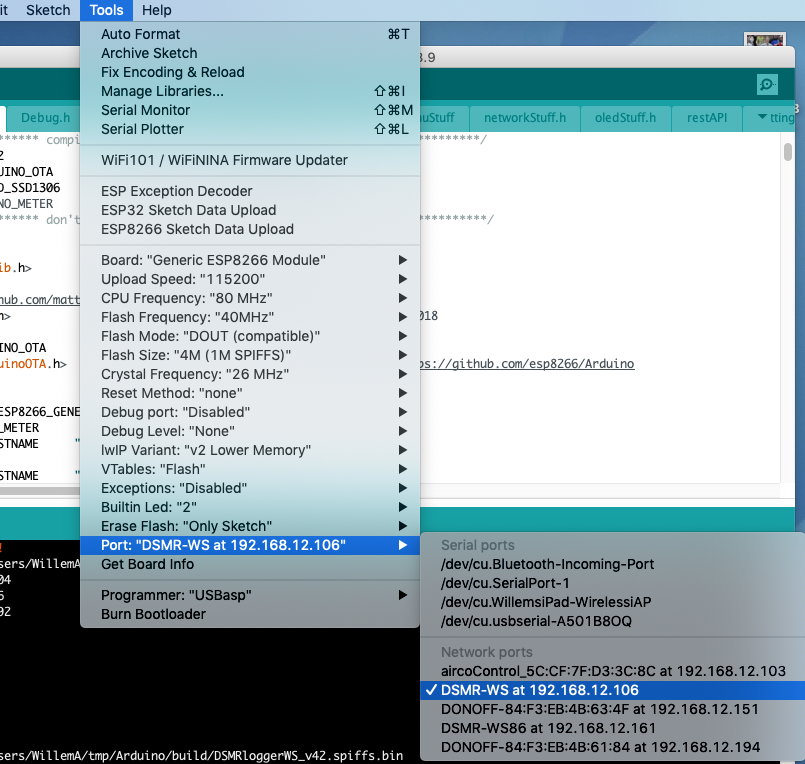
mkdocs/docs/img/IDE_Network_Port.png
