mrWheel/DSMRloggerWS/mkdocs/docs/img/RJ10-4P4C-plug.png

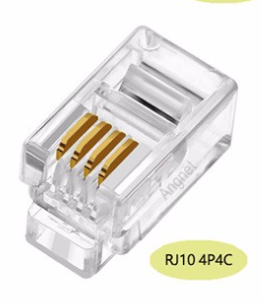
mkdocs/docs/img/RJ10-4P4C-plug.png
