mrWheel/DSMRloggerWS/mkdocs/docs/img/RJ11-6P4C-plug.png

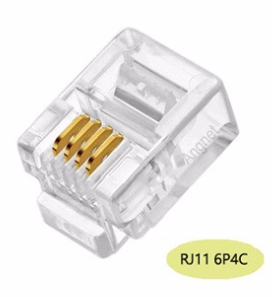
mkdocs/docs/img/RJ11-6P4C-plug.png
