mrWheel/DSMRloggerWS/mkdocs/docs/img/RJ12-6P6C-plug.png

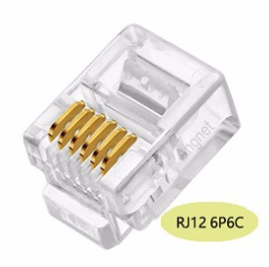
mkdocs/docs/img/RJ12-6P6C-plug.png
