mrWheel/DSMRloggerWS/mkdocs/docs/img/RJ12.png

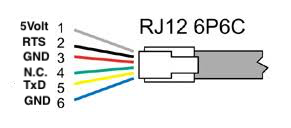
mkdocs/docs/img/RJ12.png
