mrWheel/DSMRloggerWS/mkdocs/docs/img/RJ12_Power_Hack.jpg

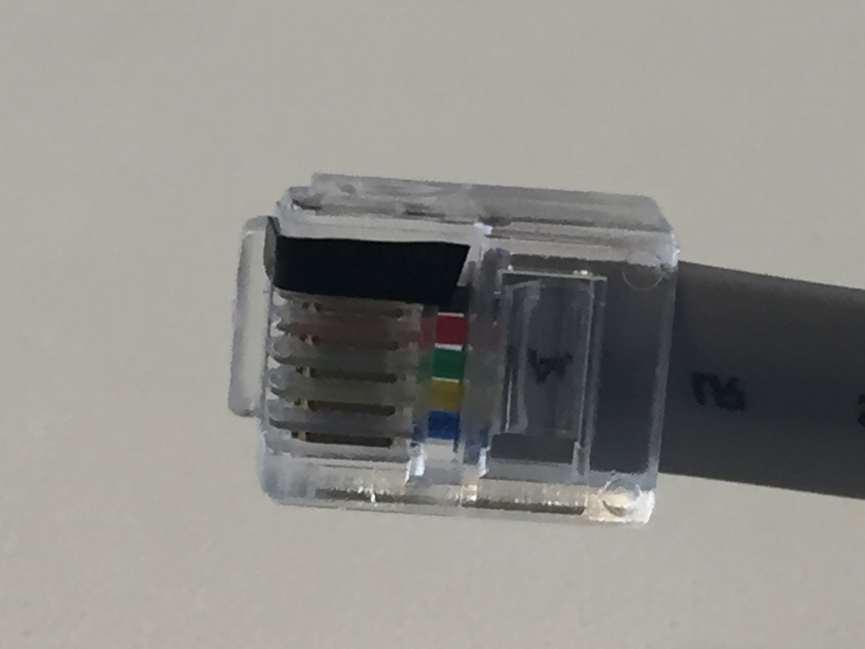
mkdocs/docs/img/RJ12_Power_Hack.jpg
