mrWheel/DSMRloggerWS/mkdocs/docs/img/RJxx-Plug-Front.png

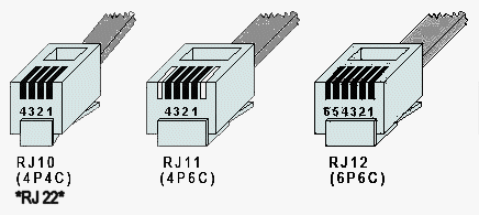
mkdocs/docs/img/RJxx-Plug-Front.png
