mrWheel/DSMRloggerWS/mkdocs/docs/img/Select ZIP.png

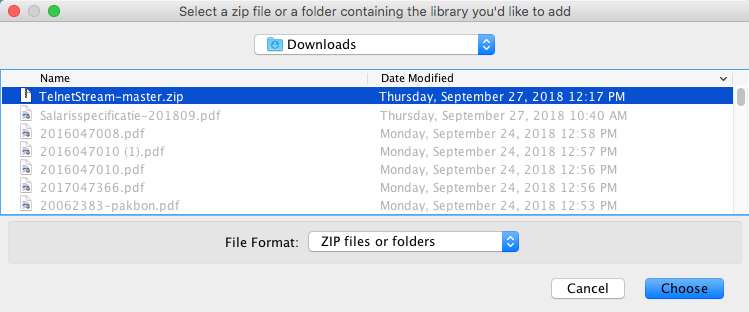
mkdocs/docs/img/Select ZIP.png
