mrWheel/DSMRloggerWS/mkdocs/docs/img/SH1106_Display.jpg

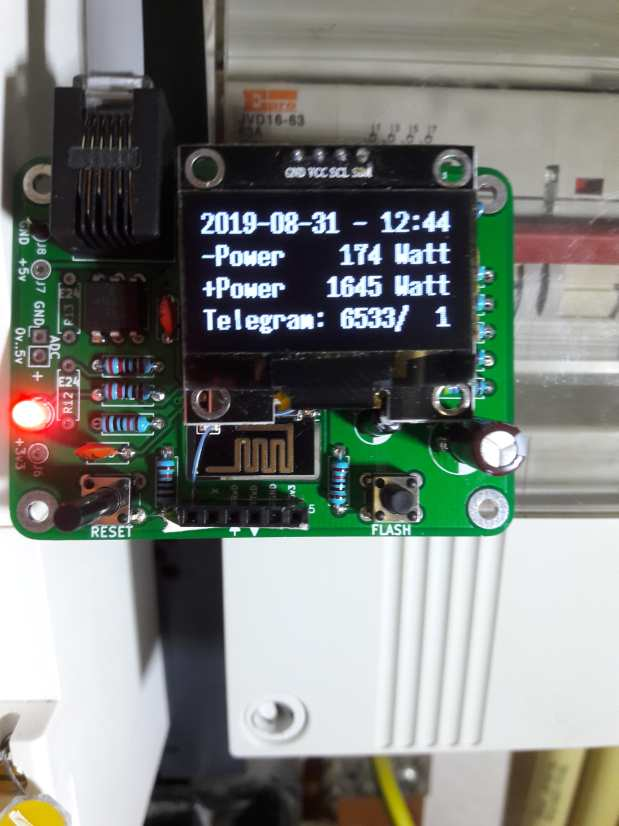
mkdocs/docs/img/SH1106_Display.jpg
