mrWheel/DSMRloggerWS/mkdocs/docs/img/USB2Serial_1of!-ESP12.png

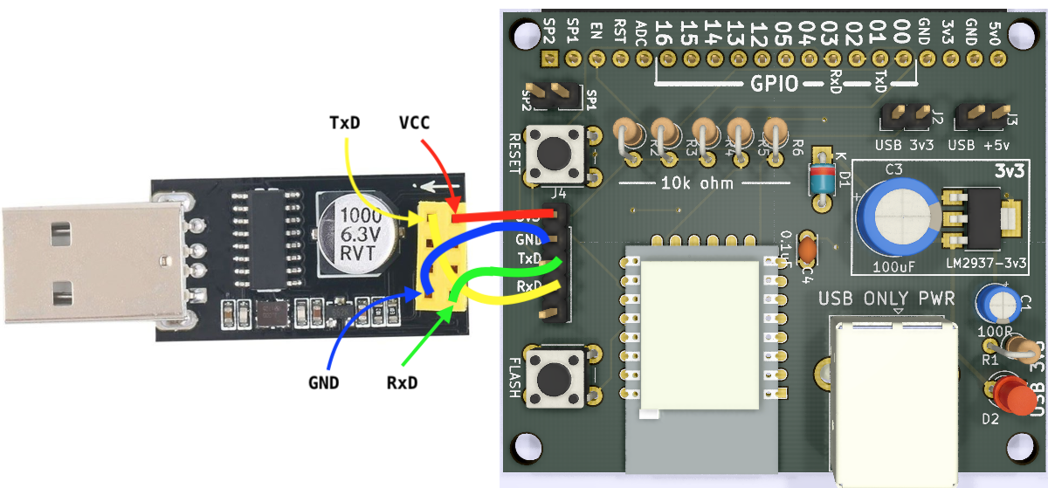
mkdocs/docs/img/USB2Serial_1of!-ESP12.png
