mrWheel/DSMRloggerWS/mkdocs/site/img/Allard-box-top.jpg

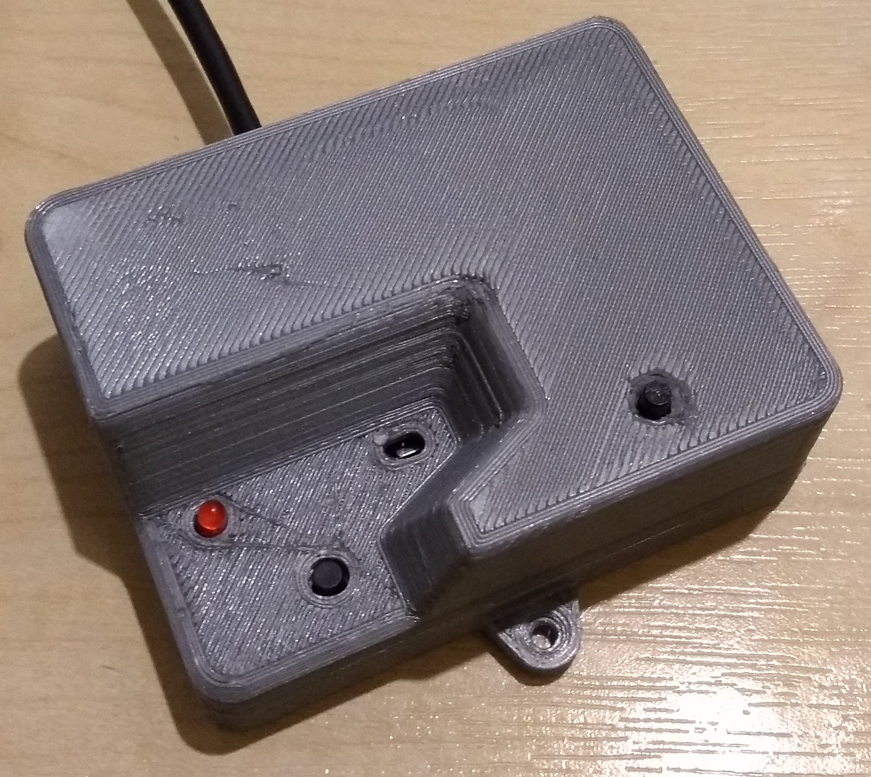
mkdocs/site/img/Allard-box-top.jpg
