mrWheel/DSMRloggerWS/mkdocs/site/img/DSMR-loggerFSexplorer.png

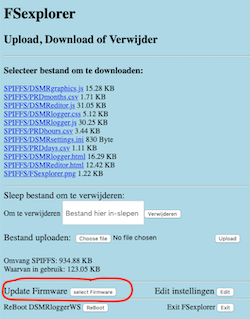
mkdocs/site/img/DSMR-loggerFSexplorer.png
