mrWheel/DSMRloggerWS/mkdocs/site/img/WIN_Preferences_Verbose.png

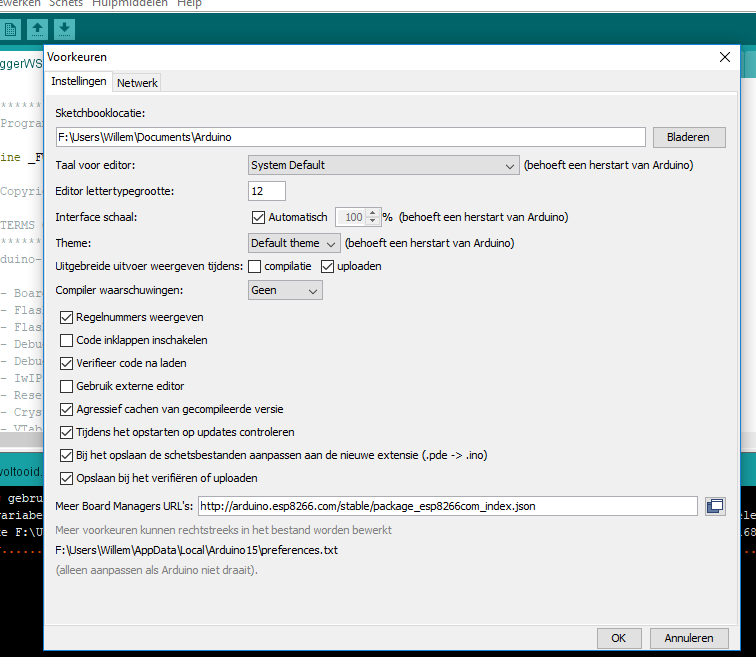
mkdocs/site/img/WIN_Preferences_Verbose.png
