mrWheel/DSMRloggerWS/mkdocs/site/installatieArduinoIDE/index.html

- Docs »
- Voorbereiding »
- ArduinoIDE

## Installatie ArduinoIDE

Download en installeer de Arduino Integrated Development Environment (IDE) voor het Operating Systeem (OS) waar jouw Desktop of Laptop computer (er zijn versies voor Windows, Linux en Mac) mee werkt.
Je kunt de Software hier (https://www.arduino.cc/en/Main/Software) downloaden.



Let op!

De DSMRloggerWS firmware is getest met de ArduinoIDE v1.8.8, v1.8.9 en v1.8.10

Let op!

De Arduino IDE v1.9.x (Beta) is NIET geschikt om deze firmware mee te compileren.
Tot v1.9.x zorgt de IDE ervoor dat alle tab-bladen (.ino files) achter elkaar worden geplakt tot één source file waarna van alle functies in dit file zgn. prototypes worden gemaakt voodat deze aan de compiler (als één file dus) wordt aangeboden. De Arduino IDE is eigenlijk de enige IDE (voor zover ik weet) die dit doet en is als zodanig dus een beetje vreemd.
v1.9.x (Beta) doet dit voor AVR processoren ook maar helaas (nog) niet voor de ESP8266 processor familie.

Na het downloaden moet je het ontvangen bestand uitpakken (unzip of untar) en installeren. Dat installeren is per OS anders maar staat duidelijk op de website van Arduino aangegeven. Eenmaal geïnstalleerd kun je direct met de Arduino IDE aan de slag.

Om de IDE met de ESP8266 microprocessor te kunnen gebruiken moeten we nog wat stappen uitvoeren.

[DSMR-Chart Financieel]


Next Previous

copyright © 2019-2020 Willem Aandewiel (https://willem.aandewiel.nl/index.php/2019/04/09/dsmr-logger-v4-slimme-meter-uitlezer/)
DSMRloggerWS Version 1.0.5
Deze pagina is 2019-12-29 voor het laatst bijgewerkt.
Built with MkDocs (http://www.mkdocs.org) using a theme (https://github.com/snide/sphinx_rtd_theme) provided by Read the Docs (https://readthedocs.org).

« Previous Next »
