mrWheel/DSMRloggerWS/mkdocs/docs/img/RJxx-Plug-Wiring.png

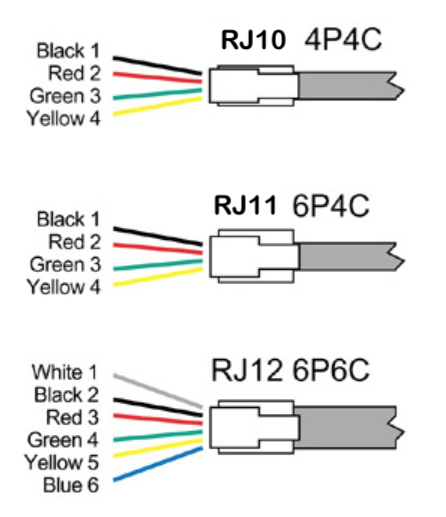
mkdocs/docs/img/RJxx-Plug-Wiring.png
