mrWheel/DSMRloggerWS/(threads)

Thread 1 (2019-06-06):

SyntaxError: JSON.parse: bad escaped character at line 3 column 25 of the JSON data

System67, 2019-06-06:
Hi mrWheel,

Ik denk dat ik het geluk heb heb om een device te hebben met een "\\" in de naam wat op zijn beurt weer een json data fout geeft in js. Jammer anders was vanavond ook al de iobroker uitlezing van jullie logger klaar geweest :) Morgen maar een tijdelijke workaround maken om de backslash weg te halen voordat ik ga parsen.

Onderstaand de complete uitvoer van DevInfo via Firefox --> RESTer plugin:

{

 **"Identification":"Ene5\XS210 ESMR 5.0"**

,"P1_Version":"50"

,"Equipment_Id":"45303034373030303033343232"

,"Electricity_Tariff":"0001"

,"Gas_Device_Type":"3"

,"Gas_Equipment_Id":"4730303533303033373230"

,"Author":"Willem Aandewiel (www.aandewiel.nl)"

,"FwVersion":"v0.4.3 (Jun  4 2019)"

,"Compiled":"Jun  4 2019  17:01:23"

,"FreeHeap":"15488"

,"ChipID":"785380"

,"CoreVersion":"2_5_2"

,"SdkVersion":"2.2.1(cfd48f3)"

,"CpuFreqMHz":"80"

,"SketchSize":"525.812kB"

,"FreeSketchSpace":"2544.000kB"

,"FlashChipID":"00164020"

,"FlashChipSize":"4.000MB"

,"FlashChipRealSize":"4.000MB"

,"FlashChipSpeed":"40.00MHz"

,"FlashChipMode":"DOUT"

,"BoardType":"ESP8266_GENERIC"

,"SSID":"Sensornet"

,"IpAddress":"192.168.999.999"

,"WiFiRSSI":"-70"

,"Hostname":"DSMR-WS"

,"upTime":"1(d):02:46"

,"TelegramCount":"9632"

,"TelegramErrors":"7"

,"lastReset":"Power on"

}

Grtz,
Carlo

mrWheel, 2019-06-19:
@System67
Lukt het om de backslash op te vangen?
Wat ben je precies aan het maken?

System67, 2019-06-19:
Hi mrWheel,

Jahoor, ik heb hem uiteindelijk afgevangen door in javascript het result eerst als string in te lezen dan te escapen en weer te casten als een json object. Daardoor verlies ik de slash niet :)
2 regels code waren genoeg.

var myJSON = content.replace("\\\\", "\\\\\\\\");  ( 2 en 4 backslashes)
content = JSON.parse(myJSON);

Als sinds een kleine 14 dagen leest een ioBroker module de DSMR informatie uit en die worden weer gebruikt in ioBroker meters en grafieken. De git repo hiervoor staat nog private omdat het mijn eerste ioBroker module EN mijn eerste javascript ervaring is, maar ik wil hem deze week public maken.

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

System67, 2019-06-19:
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

Hi,

Ik was eigenlijk niet van plan in de Arduino code te duiken maar na een paar minuten te hebben gezocht naar regel 44 en een mogelijkheid om de backslash te escapen heb ik de aangepaste code op de logger gezet en het werkt!

Ik programmeer wel al meer dan 25 jaar professioneel maar ik ben nog niet zo handig met git dus onderstaand mijn aanpassing:

In restAPI.ino (startende bij regel 97):

```
  wsString += "\n\r}\n\r";

// Fix unescaped character \ (possible in Identification field)
  wsString.replace("\\","\\\\");

  httpServer.send(200, "application/json", wsString);
```

De aanpassing checkt de hele json string.
Bedankt voor de tip!
Grtz,
Carlo

Closed 2019-07-21.

Thread 2 (2019-09-12):

Compiling of this set fails with errors.

Tokn59, 2019-09-12:
Eror messages .. Any idea what's going wrong ? Probably library mismatch ? Thank You !!!!

In file included from sketch\UpdateServer.cpp:17:0:

sketch\UpdateServer.h: In member function 'void ESP8266HTTPUpdateServer::setup(ESP8266WebServer*)':

UpdateServer.h:23:21: error: 'emptyString' was not declared in this scope

       setup(server, emptyString, emptyString);

                     ^

sketch\UpdateServer.h: In member function 'void ESP8266HTTPUpdateServer::setup(ESP8266WebServer*, const String&)':

UpdateServer.h:28:27: error: 'emptyString' was not declared in this scope

       setup(server, path, emptyString, emptyString);

                           ^

sketch\UpdateServer.cpp: In constructor 'ESP8266HTTPUpdateServer::ESP8266HTTPUpdateServer(bool)':

UpdateServer.cpp:90:15: error: 'emptyString' was not declared in this scope

   _username = emptyString;

               ^

sketch\UpdateServer.cpp: In lambda function:

UpdateServer.cpp:103:23: error: 'emptyString' was not declared in this scope

       if(_username != emptyString && _password != emptyString && !_server->authenticate(_username.c_str(), _password.c_str()))

                       ^

sketch\UpdateServer.cpp: In lambda function:

UpdateServer.cpp:133:40: error: 'emptyString' was not declared in this scope

         _authenticated = (_username == emptyString || _password == emptyString || _server->authenticate(_username.c_str(), _password.c_str()));

                                        ^

exit status 1
In file included from C:\Users\tonyk\AppData\Local\Arduino15\packages\esp8266\hardware\esp8266\2.4.2\cores\esp8266/Arduino.h:259:0,

                 from sketch\DSMRloggerWS.ino.cpp:1:

C:\Users\tonyk\AppData\Local\Arduino15\packages\esp8266\hardware\esp8266\2.4.2\cores\esp8266/pgmspace.h:16:51: error: __c causes a section type conflict with __c

#define PSTR(s) (__extension__({static const char __c[] PROGMEM = (s); &__c[0];}))

                                                   ^

C:\Users\tonyk\AppData\Local\Arduino15\packages\esp8266\hardware\esp8266\2.4.2\cores\esp8266/WString.h:38:76: note: in definition of macro 'FPSTR'

#define FPSTR(pstr_pointer) (reinterpret_cast<const __FlashStringHelper *>(pstr_pointer))

                                                                            ^

C:\Users\tonyk\AppData\Local\Arduino15\packages\esp8266\hardware\esp8266\2.4.2\cores\esp8266/WString.h:39:34: note: in expansion of macro 'PSTR'

#define F(string_literal) (FPSTR(PSTR(string_literal)))

                                  ^

C:\Users\tonyk\Dropbox\ESP8266 Projects\DSMRloggerWS-master\DSMRloggerWS\DSMRloggerWS.ino:258:28: note: in expansion of macro 'F'

         TelnetStream.print(F(": "));

                            ^

In file included from C:\Users\tonyk\Dropbox\ESP8266 Projects\DSMRloggerWS-master\DSMRloggerWS\DSMRloggerWS.ino:102:0:

C:\Users\tonyk\AppData\Local\Arduino15\packages\esp8266\hardware\esp8266\2.4.2\cores\esp8266/pgmspace.h:16:51: note: '__c' was declared here

#define PSTR(s) (__extension__({static const char __c[] PROGMEM = (s); &__c[0];}))

                                                   ^

sketch\Debug.h:53:49: note: in definition of macro 'Debugln'

                            TelnetStream.println(__VA_ARGS__);                                   \

                                                 ^

C:\Users\tonyk\AppData\Local\Arduino15\packages\esp8266\hardware\esp8266\2.4.2\cores\esp8266/WString.h:39:28: note: in expansion of macro 'FPSTR'

#define F(string_literal) (FPSTR(PSTR(string_literal)))

                            ^

C:\Users\tonyk\AppData\Local\Arduino15\packages\esp8266\hardware\esp8266\2.4.2\cores\esp8266/WString.h:39:34: note: in expansion of macro 'PSTR'

#define F(string_literal) (FPSTR(PSTR(string_literal)))

                                  ^

C:\Users\tonyk\Dropbox\ESP8266 Projects\DSMRloggerWS-master\DSMRloggerWS\settingsStuff.ino:274:11: note: in expansion of macro 'F'

   Debugln(F("\r\n==== Chart colors ===============================================\r"));

           ^

'emptyString' was not declared in this scope

mrWheel, 2019-09-13:
Yes, you compiled with "esp8266\2.4.2\cores" but this has to be "2.5.0" or better yet "2.5.2"

Update using the Boards Manager

rspaargaren, 2019-12-07:
the library does not compile with esp library 2.5.3!

mrWheel, 2019-12-07:
That's what is says in the documentation.
It is tested with core 2.5.0 and core 2.5.2!

rspaargaren, 2019-12-08:
Yes I know, it also not directly an issue more a note that it will not compile with the latest esp libraries. So maybe it will help somebody  avoid a problem.

mrWheel, 2019-12-08:
@rspaargaren
Of course you are right.
At the moment we are working hard on the next release (v1.0.4).
After that we will dive into the problems with core 2.6.0 and 2.6.2. That will take some time though!

Closed 2019-09-13.

Thread 3 (2019-09-12):

Mqtt

SJoWie80, 2019-09-12:
Ik zou graag bij MQTT
de voltage van L1 L2 L3 willen zien.
Is dat mogenlijk?

mrWheel, 2019-09-13:
Dat kan als de Slimme Meter die informatie geeft.

alveola, 2019-10-06:
Jawel, dat gaat zeker. Als je al eerder de firmware met Arduino hebt gemaakt, is dit vrij eenvoudig. Hier volgt een voorbeeld voor `Voltage_l1`.

1. test eerst of je meter deze info wel geeft:
- type de volgende URL in je browser: http://dsmr-ws.local/restAPI?get=Actueel
- zie je ergens staan: `"Voltage_l1":"221.5"`, dan wordt er dus in ieder geval `Voltage_l1` doorgegeven

2. code aanpassen:
- zoek het bestand `MQTTstuff.ino`
- voeg hierin de volgende regels toe. (Ik heb het onder het laatste topic, `PowerReturned_l3` gezet. In mijn huidige versie, 1.0.2, is dat in regel 210)

```
  topicId = String(settingMQTTtopTopic) + "/Voltl1";
  dtostrf(Voltage_l1, 9, 1, fChar);
  MQTTclient.publish(topicId.c_str(), fChar);
  json += ",\"V1\":" + trimVal(fChar);
```

3. Opnieuw de `.bin` file aanmaken en uploaden via de webpagina. Zie hiervoor in de documentatie online.

Veel succes!

mrWheel, 2019-10-07:
;-)

Closed 2019-09-13.

Thread 34 (2020-02-05):

Gas usage not shown in MQTT export

TychoSchenkeveld, 2020-02-05:
Logging this issue for a friend of mine.

He has recently moved and in his new house the DSMR telegram seems a bit different. In the raw data the gas metering is still present:

0-2:24.2.1(200205105000W)(04405.129*m3)

However the DSMR board is no longer publishing this metric on MQTT.

Could this be to do with a newer version of the DSMR telegram?

PS: He's using the release build of 1.0.4 from the release pages here. It looks like it's using the ESMR 5.0 protocol:

!80F9
/Ene5\T210-D ESMR5.0

TychoSchenkeveld, 2020-02-05:
It seems to be related to this issue in the parsing library: https://github.com/matthijskooijman/arduino-dsmr/issues/19

Apparently it could be solved by changing the MBUS value but not sure how to do this in this application :)

mrWheel, 2020-03-15:
You can edit the fields.h file in the original arduino-dsmr library from Matthijs somewhere near line 174. Just switch 1 for 2 and in the next line 2 for 1.
```
const uint8_t GAS_MBUS_ID = 1;
const uint8_t WATER_MBUS_ID = 2;
const uint8_t THERMAL_MBUS_ID = 3;
const uint8_t SLAVE_MBUS_ID = 4;
```
We are working (Matthijs that is) on a more generic solution for this.

MathieuMH, 2020-04-17:
Hi, I have a similar problem. My telegrams show that the gas usage is on 0-1. Which is the default value set for v1.0.4. But it remains zero in the rest API and website.

This is my telegram I recorded using putty.
`
0-0:96.1.4(50213)
0-0:96.1.1(3153414731313030303633313635)
0-0:1.0.0(200417154259S)
1-0:1.8.1(000463.612*kWh)
1-0:1.8.2(000469.319*kWh)
1-0:2.8.1(000374.625*kWh)
1-0:2.8.2(000126.898*kWh)
0-0:96.14.0(0001)
1-0:1.7.0(00.000*kW)
1-0:2.7.0(02.009*kW)
1-0:32.7.0(231.7*V)
1-0:31.7.0(008*A)
0-0:96.3.10(1)
0-0:17.0.0(999.9*kW)
1-0:31.4.0(999*A)
0-0:96.13.0()
0-1:24.1.0(003)
0-1:96.1.1(37464C4F32313139303930323337)
0-1:24.4.0(1)
0-1:24.2.3(200417153959S)(00604.497*m3)
`

mrWheel, 2020-04-17:
@MathieuMH
Please post this as a comment on my website.

TychoSchenkeveld, 2020-04-17:
> You can edit the fields.h file in the original arduino-dsmr library from Matthijs somewhere near line 174. Just switch 1 for 2 and in the next line 2 for 1.

I only saw this message now. But yes that's what I did there :) It worked well! I should have commented back about this when I found the solution.

mrWheel, 2020-04-17:
@TychoSchenkeveld @MathieuMH

This is not the same problem Matthieu has. His gas-meter is on the MBUS-1

`0-1:24.4.0(1)`

Closed 2020-03-15.

Thread 40 (2020-04-16):

Changed firmware caused unreadable JSON

rwaaren, 2020-04-16:
Hi,

someone using your script encounters an issue with it because of new firmware and posted this question [this question on the domoticz forum ](https://www.domoticz.com/forum/viewtopic.php?f=6&t=32218)
I wonder if you could help him or rewrite the script in dzVents to make it more easy to adapt.

Thanks !

mrWheel, 2020-04-16:
@rwaaren
I did not write the Domoticz script so I can be of little help.

Point is, this firmware is “end of life” and the new firmware uses a more generic form for the api’s.

Closed 2020-04-16.

Thread 41 (2020-10-20):

Compile and flash error

tonysprenk, 2020-10-20:
I'm getting this error:

```
Arduino: 1.8.14 Hourly Build 2020/09/23 10:35 (Mac OS X), Board: "Generic ESP8266 Module, 80 MHz, Flash, Disabled (new can abort), All SSL ciphers (most compatible), no dtr, no_sync, 26 MHz, 40MHz, DOUT (compatible), 4MB (FS:1MB OTA:~1019KB), 2, nonos-sdk 2.2.1+100 (190703), v2 Lower Memory, Disabled, None, Only Sketch, 115200"

Executable segment sizes:
IROM   : 460624          - code in flash         (default or ICACHE_FLASH_ATTR)
IRAM   : 28076   / 32768 - code in IRAM          (ICACHE_RAM_ATTR, ISRs...)
DATA   : 1460  )         - initialized variables (global, static) in RAM/HEAP
RODATA : 18456 ) / 81920 - constants             (global, static) in RAM/HEAP
BSS    : 30576 )         - zeroed variables      (global, static) in RAM/HEAP
Sketch uses 508616 bytes (48%) of program storage space. Maximum is 1044464 bytes.
Global variables use 50492 bytes (61%) of dynamic memory, leaving 31428 bytes for local variables. Maximum is 81920 bytes.
esptool.py v2.8
Serial port /dev/cu.usbserial-01B03819
Traceback (most recent call last):
  File "/Users/tonysprenkeling/Library/Arduino15/packages/esp8266/hardware/esp8266/2.6.3/tools/upload.py", line 65, in <module>
    esptool.main(cmdline)
  File "/Users/tonysprenkeling/Library/Arduino15/packages/esp8266/hardware/esp8266/2.6.3/tools/esptool/esptool.py", line 2900, in main
    print("Chip is %s" % (esp.get_chip_description()))
  File "/Users/tonysprenkeling/Library/Arduino15/packages/esp8266/hardware/esp8266/2.6.3/tools/esptool/esptool.py", line 1034, in get_chip_description
    efuses = self.get_efuses()
  File "/Users/tonysprenkeling/Library/Arduino15/packages/esp8266/hardware/esp8266/2.6.3/tools/esptool/esptool.py", line 1028, in get_efuses
    return (self.read_reg(0x3ff0005c) << 96 |
  File "/Users/tonysprenkeling/Library/Arduino15/packages/esp8266/hardware/esp8266/2.6.3/tools/esptool/esptool.py", line 490, in read_reg
    val, data = self.command(self.ESP_READ_REG, struct.pack('<I', addr))
  File "/Users/tonysprenkeling/Library/Arduino15/packages/esp8266/hardware/esp8266/2.6.3/tools/esptool/esptool.py", line 347, in command
    p = self.read()
  File "/Users/tonysprenkeling/Library/Arduino15/packages/esp8266/hardware/esp8266/2.6.3/tools/esptool/esptool.py", line 292, in read
    return next(self._slip_reader)
  File "/Users/tonysprenkeling/Library/Arduino15/packages/esp8266/hardware/esp8266/2.6.3/tools/esptool/esptool.py", line 2057, in slip_reader
    raise FatalError('Invalid head of packet (0x%s)' % hexify(b))
esptool.FatalError: Invalid head of packet (0x72)
esptool.FatalError: Invalid head of packet (0x72)

Connecting...
```

What am I doing wrong?

tonysprenk, 2020-10-20:
Got it to work. Had the wrong reset method selected.

Closed 2020-10-20.

Thread 42 (2020-12-12):

FR for a new DSMR; external wifi antenna

SamJongenelen, 2020-12-12:
First, this is not really about the software, but a hardware design request for the opencircuit design.

I've been happily using the DSMRlogger 4.5 but I was wondering, I you would make a new iteration of the circuit, to include an external wifi antenna

The wifi under my stairs is spotty and an antenna would help me place the device itself in a better position :)

mrWheel, 2022-05-15:
Hi @SamJongenelen,

Sorry, but I'm not going to make a new iteration of the hardware or firmware.

Closed 2022-05-15.

Thread 43 (2021-01-20):

Gebruik op een Wemos D1 Mini Pro

hanslammerts, 2021-01-20:
Hi Willem,

Ik heb de software geinstalleerd op een Wemos D1 Mini Pro. En zo te zien werkt de website prima.
Echter, ik heb natuurlijk wat andere hardware dan waar je deze software voor hebt ontworpen om het
signaal van de P1 poort om te zetten. Schema heb ik gevonden in een blog die je zelf hebt geschreven:
[https://opencircuit.shop/Blog/Slimme-meter-uitlezer].

Ik zie de led op de Wemos zo'n 10 seconden branden, waarna hij weer uitgaat, ook voor 10 seconden.
Ik zou daaruit kunnen afleiden dat de schakeling werkt, maar ik zie geen data binnenkomen. Als ik met telnet
naar de Wemos ga, en ik wil met P de raw data bekijken, dan zie ik niets binnenkomen.

Is het knipperen van de led (10 sec aan, 10 sec uiit) een indicatie dat ik telegrammen binnenkrijg ?
Doet deze software net iets anders waardoor de telegrammen met mijn hardware niet worden opgepikt ?

Groeten,
Hans

mrWheel, 2022-05-15:
@hanslammerts
Er is geen verschil tussen de WEMOS D1 of andere op de ESP8266 gebaseerde bordjes. Het enige wat gebeurd als je bijv. de Wemos D1 selecteert in de board manager is dat er macro's worden geladen die D1, D2 enz. omzetten naar de daadwerkelijke GPIO pinnen. In mijn optiek zinloos en volkomen overdone.
Als je als board een "Generic ESP8266" selecteert dan werkt de firmware probleemloos zonder aanpassingen.

Closed 2022-05-15.

Thread 44 (2021-02-03):

SPIFFS soon fully deprecated, how to convert to LittleFS

hoekbrwr, 2021-02-03:
I am new to this software and was looking to it to try it on my SM. I got it loaded in quite a short time by following all the extremely informational docs about it. Never seen so much docu on a system :)) - TASMOTA could be better ;) and much bigger of course-.
When I compile it in Arduino IDE I get these tons of warnings SPIFFS will be deprecated soon and you better use LitleFS! Will it be difficult to convert from SPIFFS to LittleFS?
Secondly, I am looking to PlatformIO. Are there any initiatives to convert this to make a version for PIO or can we completely switch to VSCode & PIO?

hoekbrwr, 2021-02-15:
> I am new to this software and was looking to it to try it on my SM. I got it loaded in quite a short time by following all the extremely informational docs about it. Never seen so much docu on a system :)) - TASMOTA could be better ;) and much bigger of course-.
> When I compile it in Arduino IDE I get these tons of warnings SPIFFS will be deprecated soon and you better use LitleFS! Will it be difficult to convert from SPIFFS to LittleFS?
> Secondly, I am looking to PlatformIO. Are there any initiatives to convert this to make a version for PIO or can we completely switch to VSCode & PIO?

I took the initiative and converted this  to write data with the LittleFS library.
See [this ](https://github.com/hoekbrwr/DSMRloggerAPI_LittleFS)at GitHub

Closed 2022-05-15.
