mrWheel/DSMRloggerWS/helperStuff.ino

/* 
***************************************************************************  
**  Program  : helperStuff, part of DSMRloggerWS
**  Version  : v1.0.5
**
**  Copyright (c) 2020 Willem Aandewiel
**
**  TERMS OF USE: MIT License. See bottom of file.                                                            
***************************************************************************      
*/


//===========================================================================================
bool compare(String x, String y) 
{ 
    for (int i = 0; i < min(x.length(), y.length()); i++) { 
      if (x[i] != y[i]) 
      {
        return (bool)(x[i] < y[i]); 
      }
    } 
    return x.length() < y.length(); 
    
} // compare()


//===========================================================================================
boolean isValidIP(IPAddress ip)
{
 /* Works as follows:
   *  example: 
   *  127.0.0.1 
   *   1 => 127||0||0||1 = 128>0 = true 
   *   2 => !(true && true && true && true) = false
   *   3 => !(false) = true
   *   true && false && true = false ==> correct, this is an invalid addres
   *   
   *   0.0.0.0
   *   1 => 0||0||0||0 = 0>0 = false 
   *   2 => !(true && true && true && tfalse) = true
   *   3 => !(false) = true
   *   false && true && true = false ==> correct, this is an invalid addres
   *   
   *   192.168.0.1 
   *   1 => 192||168||0||1 =233>0 = true 
   *   2 => !(false && false && true && true) = true
   *   3 => !(false) = true
   *   true && true && true = true ==> correct, this is a valid address
   *   
   *   255.255.255.255
   *   1 => 255||255||255||255 =255>0 = true 
   *   2 => !(false && false && false && false) = true
   *   3 => !(true) = false
   *   true && true && falseue = false ==> correct, this is an invalid address
   *   
   */
  boolean _isValidIP = false;
  _isValidIP = ((ip[0] || ip[1] || ip[2] || ip[3])>0);              // if any bits are set, then it is not 0.0.0.0
  _isValidIP &= !(ip[0]==127 && ip[1]==0 && ip[2]==0 && ip[3]==1);  // if not 127.0.0.0 then it might be valid
  _isValidIP &= !(ip[0]>=223); // if ip[0] >223 then reserved space  
  
  if (Verbose1) 
  {
    DebugTf( "%d.%d.%d.%d", ip[0], ip[1], ip[2], ip[3]);
    if (_isValidIP) 
      Debugln(F(" = Valid IP")); 
    else 
      Debugln(F(" = Invalid IP!"));
  }
  
  return _isValidIP;
} //  isValidIP()

/****
//===========================================================================================
String macToStr(const uint8_t* mac) 
{
  String result;
  for (int i = 0; i < 6; ++i) 
  {
    result += String(mac[i], 16);
    if (i < 5)
      result += ':';
  }
  return result;
  
} // macToStr()
****/

//===========================================================================================
int8_t splitString(String inStrng, char delimiter, String wOut[], uint8_t maxWords) 
{
  uint16_t inxS = 0, inxE = 0, wordCount = 0;
    inStrng.trim();
    while(inxE < inStrng.length() && wordCount < maxWords) 
    {
      inxE  = inStrng.indexOf(delimiter, inxS);             //finds location of first ,
      wOut[wordCount] = inStrng.substring(inxS, inxE);  //captures first data String
      wOut[wordCount].trim();
      //DebugTf("[%d] => [%c] @[%d] found[%s]\r\n", wordCount, delimiter, inxE, wOut[wordCount].c_str());
      inxS = inxE;
      inxS++;
      wordCount++;
    }
    if (inxS < inStrng.length()) 
    {
      wOut[wordCount] = inStrng.substring(inxS, inStrng.length());  //captures first data String      
      //DebugTf("[%d] rest => [%s]\r\n", wordCount, wOut[wordCount].c_str());
    }

    return wordCount;
    
} // splitString()


//===========================================================================================
String upTime() 
{
  char    calcUptime[20];

  sprintf(calcUptime, "%d(d):%02d(h):%02d", int((upTimeSeconds / (60 * 60 * 24)) % 365)
                                          , int((upTimeSeconds / (60 * 60)) % 24)
                                          , int((upTimeSeconds / (60)) % 60));

  return calcUptime;

} // upTime()


//===========================================================================================
void strConcat(char *dest, int maxLen, const char *src)
{
  if (strlen(dest) + strlen(src) < maxLen) 
  {
    strcat(dest, src);
  } 
  else
  {
    DebugTf("Combined string > %d chars\r\n", maxLen);
  }
  
} // strConcat()

//===========================================================================================
void strConcat(char *dest, int maxLen, float v, int dec)
{
  static char buff[25];
  if (dec == 0)       sprintf(buff,"%.0f", v);
  else if (dec == 1)  sprintf(buff,"%.1f", v);
  else if (dec == 2)  sprintf(buff,"%.2f", v);
  else if (dec == 3)  sprintf(buff,"%.3f", v);
  else if (dec == 4)  sprintf(buff,"%.4f", v);
  else if (dec == 5)  sprintf(buff,"%.5f", v);
  else                sprintf(buff,"%f",   v);

  if (strlen(dest) + strlen(buff) < maxLen) 
  {
    strcat(dest, buff);
  } 
  else
  {
    DebugTf("Combined string > %d chars\r\n", maxLen);
  }
  
} // strConcat()

//===========================================================================================
void strConcat(char *dest, int maxLen, int32_t v)
{
  static char buff[25];
  sprintf(buff,"%d", v);

  if (strlen(dest) + strlen(buff) < maxLen) 
  {
    strcat(dest, buff);
  } 
  else
  {
    DebugTf("Combined string > %d chars\r\n", maxLen);
  }
  
} // strConcat()


//===========================================================================================
// a 'save' version of strncpy() that does not put a '\0' at
// the end of dest if src >= maxLen!
void strCopy(char *dest, int maxLen, const char *src)
{
  dest[0] = '\0';
  strcat(dest, src);
    
} // strCopy()


//===========================================================================================
char *intToStr(int32_t v)
{
  static char buff[25];
  sprintf(buff,"%d", v);
  return buff;
  
} // intToStr()

//===========================================================================================
char *floatToStr(float v, int dec)
{
  static char buff[25];
  if (dec == 0)       sprintf(buff,"%.0f", v);
  else if (dec == 1)  sprintf(buff,"%.1f", v);
  else if (dec == 2)  sprintf(buff,"%.2f", v);
  else if (dec == 3)  sprintf(buff,"%.3f", v);
  else if (dec == 4)  sprintf(buff,"%.4f", v);
  else if (dec == 5)  sprintf(buff,"%.5f", v);
  else                sprintf(buff,"%f",   v);
  return buff;
  
} // floattToStr()

//===========================================================================================
float formatFloat(float v, int dec)
{
  return (String(v, dec).toFloat());

} //  formatFloat()


//=======================================================================        
template<typename Item>
Item& typecastValue(Item& i) 
{
  return i;
}

String typecastValue(TimestampedFixedValue i) 
{
  return String(i);
}
  
float typecastValue(FixedValue i) 
{
  return i;
}

/***************************************************************************
*
* Permission is hereby granted, free of charge, to any person obtaining a
* copy of this software and associated documentation files (the
* "Software"), to deal in the Software without restriction, including
* without limitation the rights to use, copy, modify, merge, publish,
* distribute, sublicense, and/or sell copies of the Software, and to permit
* persons to whom the Software is furnished to do so, subject to the
* following conditions:
*
* The above copyright notice and this permission notice shall be included
* in all copies or substantial portions of the Software.
*
* THE SOFTWARE IS PROVIDED "AS IS", WITHOUT WARRANTY OF ANY KIND, EXPRESS
* OR IMPLIED, INCLUDING BUT NOT LIMITED TO THE WARRANTIES OF
* MERCHANTABILITY, FITNESS FOR A PARTICULAR PURPOSE AND NONINFRINGEMENT.
* IN NO EVENT SHALL THE AUTHORS OR COPYRIGHT HOLDERS BE LIABLE FOR ANY
* CLAIM, DAMAGES OR OTHER LIABILITY, WHETHER IN AN ACTION OF CONTRACT, TORT
* OR OTHERWISE, ARISING FROM, OUT OF OR IN CONNECTION WITH THE SOFTWARE OR
* THE USE OR OTHER DEALINGS IN THE SOFTWARE.
* 
***************************************************************************/
