mrWheel/DSMRloggerWS/networkStuff.h

/*
***************************************************************************  
**  Program  : networkStuff.h, part of DSMRloggerWS
**  Version  : v1.0.5
**
**  Copyright (c) 2020 Willem Aandewiel
**
**  TERMS OF USE: MIT License. See bottom of file.                                                            
***************************************************************************      
*/

#include <ESP8266WiFi.h>        // version 1.0.0 - part of ESP8266 Core https://github.com/esp8266/Arduino
#include <ESP8266WebServer.h>   // Version 1.0.0 - part of ESP8266 Core https://github.com/esp8266/Arduino
//#include <DNSServer.h>        // part of ESP8266 Core https://github.com/esp8266/Arduino
#include <WiFiUdp.h>            // part of ESP8266 Core https://github.com/esp8266/Arduino
#include <ESP8266mDNS.h>        // part of ESP8266 Core https://github.com/esp8266/Arduino
#ifdef USE_UPDATE_SERVER
  #include <ModUpdateServer.h>  // https://github.com/mrWheel/ModUpdateServer
  #include "UpdateServerHtml.h"
#endif
#include <WiFiManager.h>        // version 0.14.0 - https://github.com/tzapu/WiFiManager
// included in main program: #include <TelnetStream.h>       // Version 0.0.1 - https://github.com/jandrassy/TelnetStream
#include <WebSocketsServer.h>   // Version 20.05.2015 - https://github.com/Links2004/arduinoWebSockets
//#include <Hash.h>
#include <FS.h>                 // part of ESP8266 Core https://github.com/esp8266/Arduino

ESP8266WebServer        httpServer (80);
#ifdef USE_UPDATE_SERVER
  ESP8266HTTPUpdateServer httpUpdater(true);
#endif

WebSocketsServer webSocket = WebSocketsServer(81);

static      FSInfo SPIFFSinfo;
bool        SPIFFSmounted; 
bool        isConnected = false;

//gets called when WiFiManager enters configuration mode
//===========================================================================================
void configModeCallback (WiFiManager *myWiFiManager) 
{
  DebugTln(F("Entered config mode\r"));
  DebugTln(WiFi.softAPIP().toString());
  //if you used auto generated SSID, print it
  DebugTln(myWiFiManager->getConfigPortalSSID());
#if defined( HAS_OLED_SSD1306 ) || defined( HAS_OLED_SH1106 )
    oled_Clear();
    oled_Print_Msg(0, "** DSMRloggerWS **", 0);
    oled_Print_Msg(1, "AP mode active", 0);
    oled_Print_Msg(2, "Connect to:", 0);
    oled_Print_Msg(3, myWiFiManager->getConfigPortalSSID(), 0);
#endif

} // configModeCallback()


//===========================================================================================
void startWiFi() 
{
  WiFiManager manageWiFi;

  String thisAP = String(_HOSTNAME) + "-" + WiFi.macAddress();
  
  manageWiFi.setDebugOutput(true);
  
  //set callback that gets called when connecting to previous WiFi fails, and enters Access Point mode
  manageWiFi.setAPCallback(configModeCallback);

  //sets timeout until configuration portal gets turned off
  //useful to make it all retry or go to sleep in seconds
  manageWiFi.setTimeout(240);  // 4 minuten
  
  //fetches ssid and pass and tries to connect
  //if it does not connect it starts an access point with the specified name
  //here  "DSMR-WS-<MAC>"
  //and goes into a blocking loop awaiting configuration
  if (!manageWiFi.autoConnect(thisAP.c_str())) 
  {
    DebugTln(F("failed to connect and hit timeout"));
#if defined( HAS_OLED_SSD1306 ) || defined( HAS_OLED_SH1106 )
    oled_Clear();
    oled_Print_Msg(0, "** DSMRloggerWS **", 0);
    oled_Print_Msg(1, "Failed to connect", 0);
    oled_Print_Msg(2, "and hit TimeOut", 0);
    oled_Print_Msg(3, "***** RESET *****", 0);
#endif

    //reset and try again, or maybe put it to deep sleep
    delay(3000);
    ESP.reset();
    delay(2000);
  }

  DebugTf("Connected with IP-address [%s]\r\n\r\n", WiFi.localIP().toString().c_str());
#if defined( HAS_OLED_SSD1306 ) || defined( HAS_OLED_SH1106 )
    oled_Clear();
#endif


#ifdef USE_UPDATE_SERVER
  httpUpdater.setup(&httpServer);
  httpUpdater.setIndexPage(UpdateServerIndex);
  httpUpdater.setSuccessPage(UpdateServerSuccess);
#endif
  
} // startWiFi()


//===========================================================================================
void startTelnet() 
{
  TelnetStream.begin();
  DebugTln(F("\nTelnet server started .."));
  TelnetStream.flush();

} // startTelnet()


//=======================================================================
void startMDNS(const char *Hostname) 
{
  DebugTf("[1] mDNS setup as [%s.local]\r\n", Hostname);
  if (MDNS.begin(Hostname))               // Start the mDNS responder for Hostname.local
  {
    DebugTf("[2] mDNS responder started as [%s.local]\r\n", Hostname);
  } 
  else 
  {
    DebugTln(F("[3] Error setting up MDNS responder!\r\n"));
  }
  MDNS.addService("http", "tcp", 80);
  
} // startMDNS()

/***************************************************************************
*
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
e without restriction, including
* without limitation the rights to use, copy, modify, merge, publish,
* distribute, sublicense, and/or sell copies of the Software, and to permit
* persons to whom the Software is furnished to do so, subject to the
* following conditions:
*
* The above copyright notice and this permission notice shall be included
* in all copies or substantial portions of the Software.
*
* THE SOFTWARE IS PROVIDED "AS IS", WITHOUT WARRANTY OF ANY KIND, EXPRESS
* OR IMPLIED, INCLUDING BUT NOT LIMITED TO THE WARRANTIES OF
* MERCHANTABILITY, FITNESS FOR A PARTICULAR PURPOSE AND NONINFRINGEMENT.
* IN NO EVENT SHALL THE AUTHORS OR COPYRIGHT HOLDERS BE LIABLE FOR ANY
* CLAIM, DAMAGES OR OTHER LIABILITY, WHETHER IN AN ACTION OF CONTRACT, TORT
* OR OTHERWISE, ARISING FROM, OUT OF OR IN CONNECTION WITH THE SOFTWARE OR
* THE USE OR OTHER DEALINGS IN THE SOFTWARE.
* 
***************************************************************************/
