mrWheel/DSMRloggerWS/(commit log)

2019-04-19 First Final Release van de documentatie
2019-05-01 Laatste hand aan de documentatie(?)
2019-05-22 5 volt programmer
2019-05-23 Bug in opbouw urenTabel opgelost. Thanx Pim!
    [DSMRloggerWS.ino]
2019-06-10 Div. aanpassingen in de documentatie (thanx Eric)
2019-06-10 Kleine aanpassingen in de documentatie
2019-06-23 Pinout Opto Coupler
2019-07-19 Externe 5 volt mod.
2019-10-19 DSMRloggerWS firmware v1.0.3 - Uitbreiding velden die naar een MQTT broker gestuurd kunnen worden - Bij de 'MQTT broker URL/IP' kan nu ook een poortnummer opgegeven worden maar uiteraard géén poort d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
    [Debug.h, FSexplorer.ino, MQTTstuff.ino, SPIFFSstuff.ino, has_no_meter.h, menuStuff.ino, networkStuff.h, ntpStuff.ino]
2019-11-21 v1.0.3b is een tussen release. Hij checkt bij het opstarten of alle noodzakelijke bestanden in SPIFFS staan
2019-11-22 Bug fix voor v1.0.3b
    [DSMRloggerWS.ino, Debug.h, MQTTstuff.ino, SPIFFSstuff.ino, menuStuff.ino, restAPI.ino, settingsStuff.ino, webSocketEvent.ino]
2019-11-22 Pre stage v1.0.4
2019-12-29 V1.0.4 (#29)
    * Mindergas-Integration
    Mindergas.nl Integration into the firmware
    - Added mindergas integration
    - Debug minor changes to firmware
    - Changed the precision to 3 digits
    * Mindergas Integration of UI
    This should update the Settings page on the firmware for Mindergas.
    * Mindergas-fix-UI-integration
    bug fix
    * Mindergas AuthToken in Settings UI
    Working firmware with Mindergas Token integrated in Settings page.
    * Update Readme.md
    Update readme.md to reflect the Mindergas integration
    * Fixed the readme.md
    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
    [DSMRloggerWS.ino, Debug.h, FSexplorer.ino, MQTTstuff.ino, MinderGas.ino, SPIFFSstuff.ino]
